JonCra/Smokehouse/ControlStation/Schematics/Board 1 - Control Station_MASTER/ControlStationPCB_Front.png

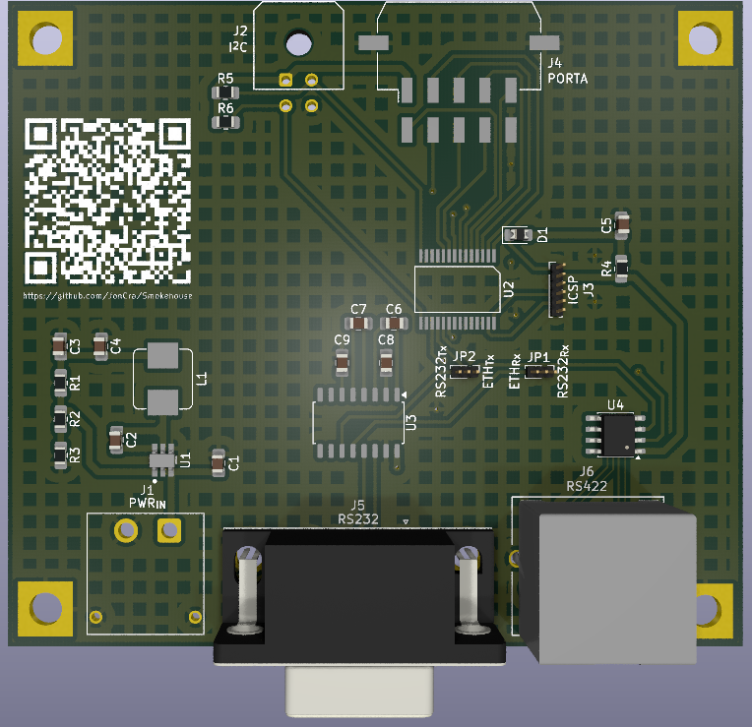
ControlStation/Schematics/Board 1 - Control Station_MASTER/ControlStationPCB_Front.png
