JonCra/Smokehouse/ControlStation/Images-Assets/FunctionalTestCircuit.png

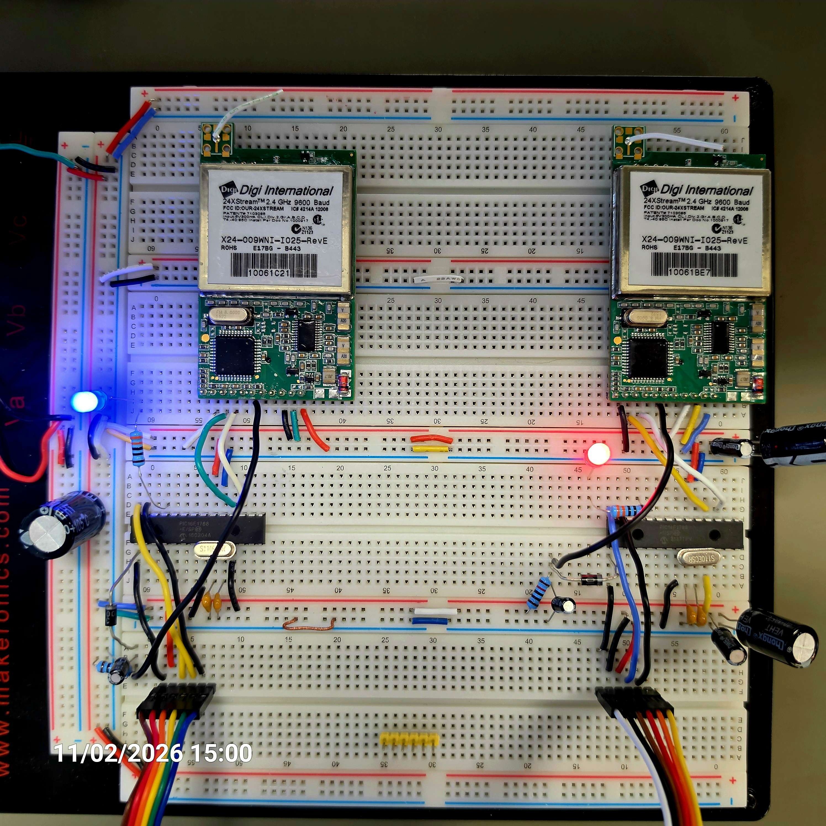
ControlStation/Images-Assets/FunctionalTestCircuit.png
