JonCra/Smokehouse/README.md

# Project Smokehouse - RCET Project (Fall 2026 Semester)
## Continuation of [Project BLOODHOUND](https://github.com/rc-earnest/BloodHound)
### Smokehouse Contributors (Fall 2026 Semester)
<dl>
<dt>Micah Spencer - Project Lead, 6th Semester RCET Student</dt>
<dd>Redesign and improvement of drive controller(s) and addition of semi-permanent peripheral data collection</dd>
<dt>Jonas Cram - Project Lead, 6th Semester RCET Student</dt>
<dd>Design and construction of "control/base station" for remote operations</dd>
</dl>

### BLOODHOUND Contributors (Spring 2026 Semester)
<dl>
<dt>Noah Holloway - Project Lead, 6th Semester RCET Student</dt>
<dd>ATV steering/driving controls and physical/electrical hardware</dd>
<dt>Rudy Earnest - Project Lead, 6th Semester RCET Student</dt>
<dd>Pan-Tilt-Zoom (PTZ) Cameras and other peripherals</dd>
<dt>Micah Spencer - Project Assistant, 5th Semester RCET Student</dt>
<dd>Real-Time Kinematics (RTK)/GPS Module</dd>
<dt>Jonas Cram - Project Assistant, 5th Semester RCET Student</dt>
<dd>Light Detection and Ranging (LiDAR) Module</dd>
