JonCra/Smokehouse/ControlStation/Images-Assets/OriginalControlStation_Uncovered.jpg

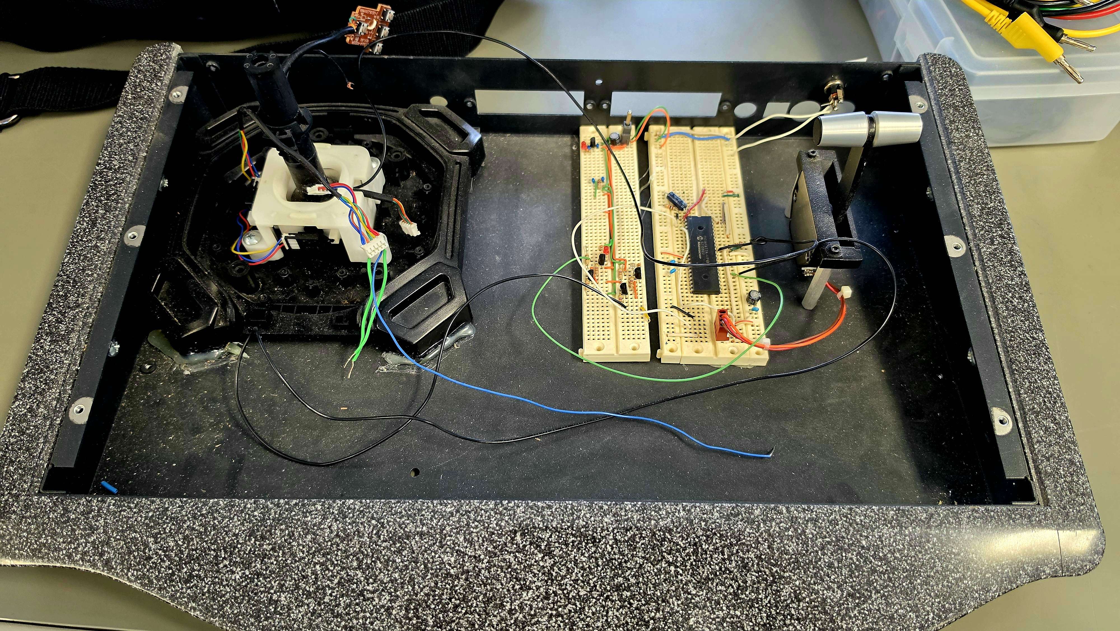
ControlStation/Images-Assets/OriginalControlStation_Uncovered.jpg
