JonCra/Smokehouse/ControlStation/Images-Assets/ReceiverBoard_Back.png

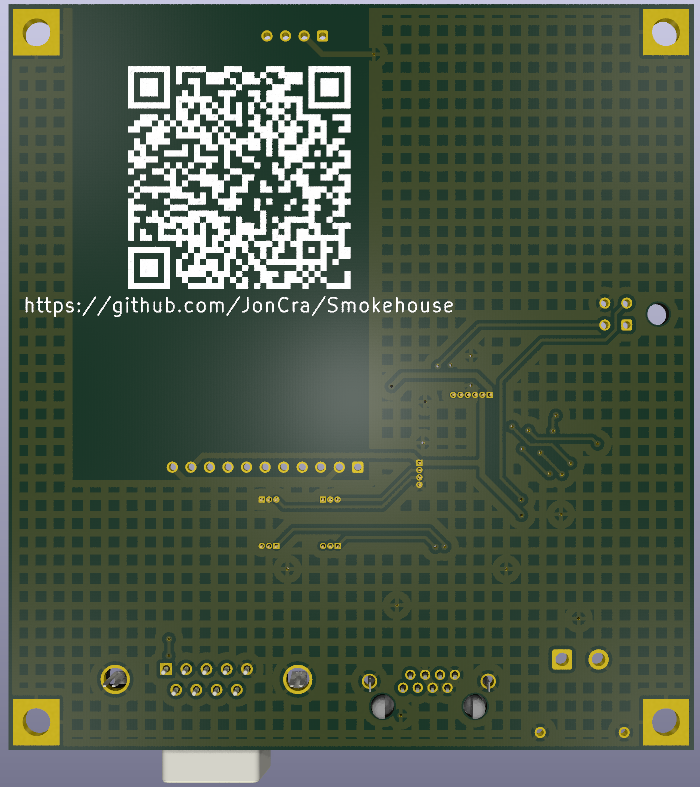
ControlStation/Images-Assets/ReceiverBoard_Back.png
