JonCra/Smokehouse/ControlStation/Images-Assets/ReceiverBoard_Front.png

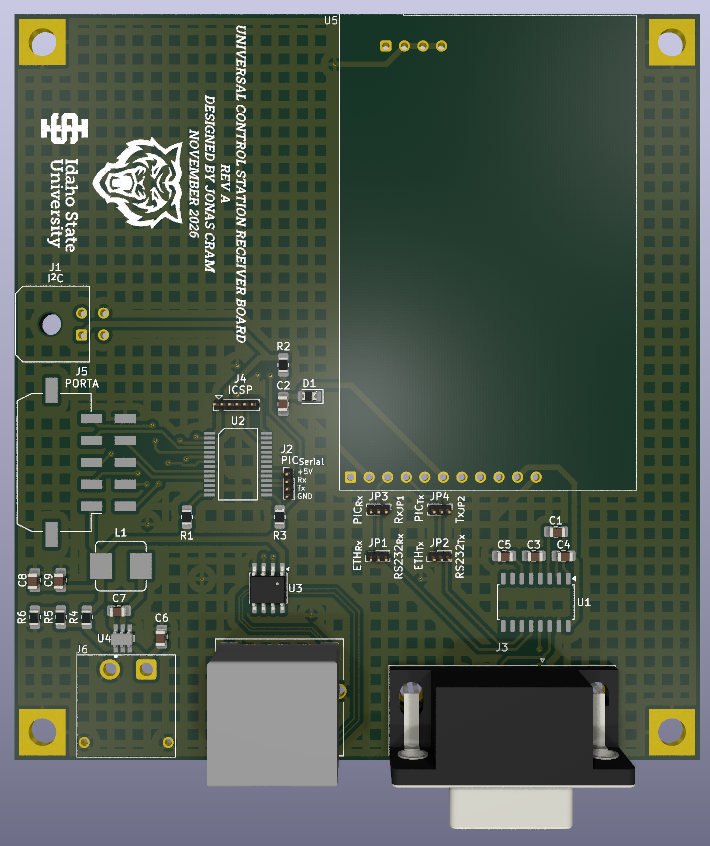
ControlStation/Images-Assets/ReceiverBoard_Front.png
