JonCra/Smokehouse/ControlStation/Images-Assets/RX_PIC_LED_Period.png

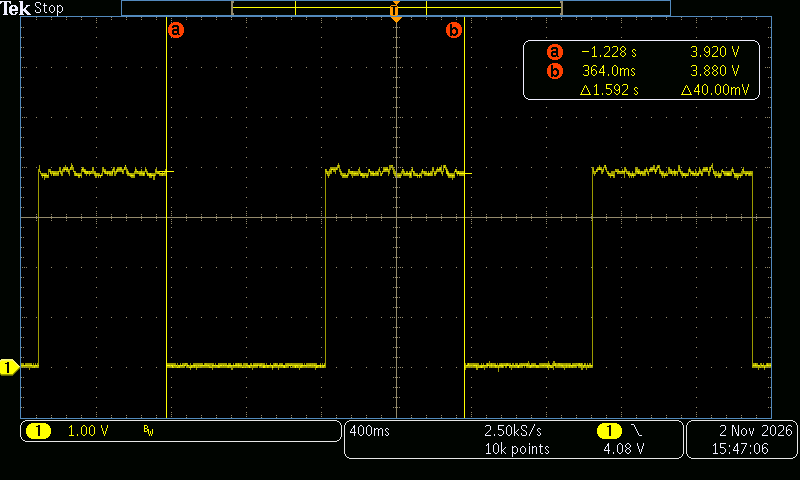
ControlStation/Images-Assets/RX_PIC_LED_Period.png
