JonCra/Smokehouse/ControlStation/Images-Assets/TX_PIC_LED_Period.png

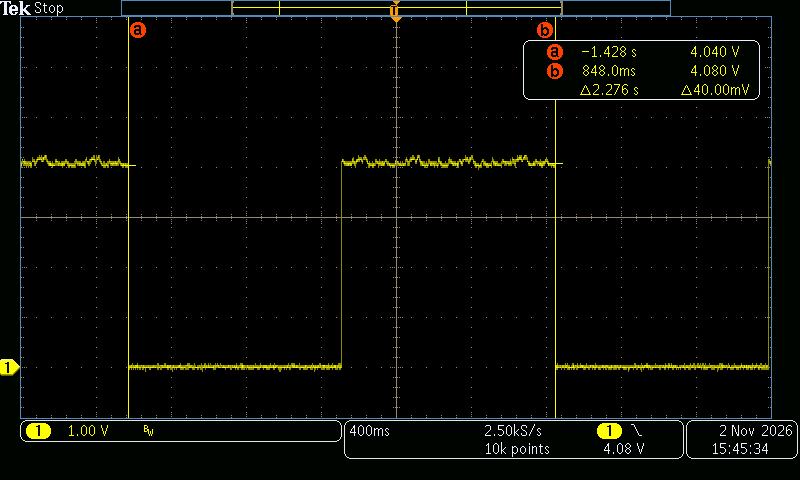
ControlStation/Images-Assets/TX_PIC_LED_Period.png
