JonCra/Smokehouse/ControlStation/Schematics/Board 1 - Control Station_MASTER/ControlStationPCB_Back.png

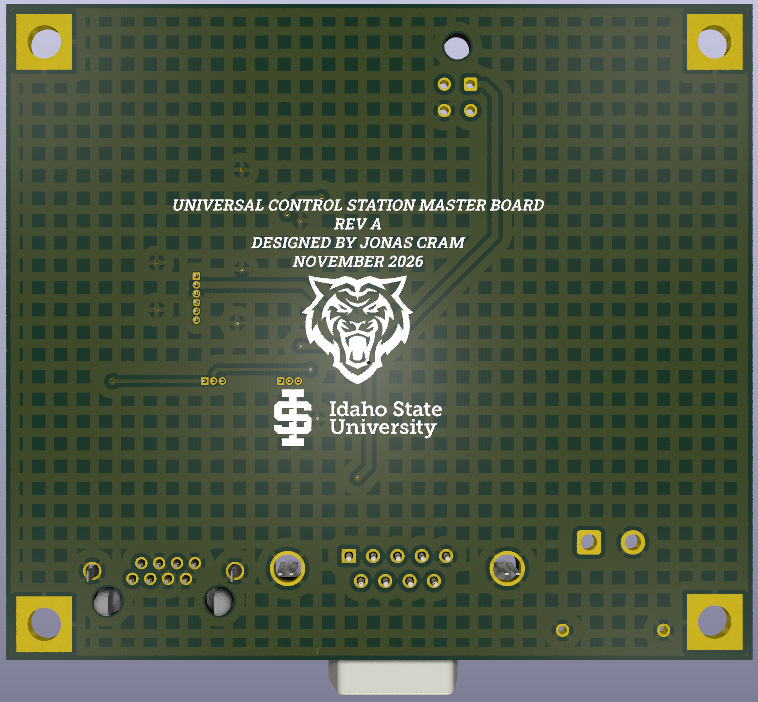
ControlStation/Schematics/Board 1 - Control Station_MASTER/ControlStationPCB_Back.png
