JonCra/Smokehouse/ControlStation/Schematics/Board 2 - Receiver_SLAVE/ReceiverBoard_BOM.pdf

# | Reference | Qty | Value | Description | Footprint | Digikey Part | Unit Price | Price / 100 units | Total Price

1 | C1, C3, C4, C5 | 4 | 1μF | CAP0805 Y5V 1UF Z-TOL 50V | Capacitor_SMD:C_0805_2012Metric_Pad1.1 8x1.45mm_HandSolder | 4713-GMC21Y5V105Z5 0NTTR-ND | $ 0.13 | $ 0.04 | $ 0.52
2 | C2 | 1 | 10μF | CAP0805 X5R 10UF 20% 50V | | 4713-GMC21X5R106M 50NTTR-ND | $ 1.62 | $ 0.79 | $ 1.62
3 | C6 | 1 | 2.2μF | CAP0805 X7R 2.2UF 10% 50V | | 4713-GMC21X7R225K 50NTTR-ND | $ 0.36 | $ 0.14 | $ 0.36
4 | C7 | 1 | 100nF | CAP0805 X7R .1UF 10% 50V | | 4713-GMC21X7R104K5 0NTTR-ND | $ 0.10 | $ 0.03 | $ 0.10
5 | C8, C9 | 2 | 22μF | CAP0805 X5R 22UF 20% 25V | | 4713-GMC21X5R226M 25NTTR-ND | $ 0.76 | $ 0.33 | $ 1.52
6 | D1 | 1 | 1N4148 or Equivelant | DIODE STANDARD 75V 150MA 0805 | | 1801-TS4148RBGTR-ND | $ 0.13 | $ 0.05 | $ 0.13
7 | J1 | 1 | I 2C | CONN HEADER R/A 4POS 3MM | Connector_Molex:Molex_Micro-Fit_3.0_43045-0400_2x02_P3.00mm_Horizontal | WM1814-ND | $ 1.45 | $ 1.05 | $ 1.45
8 | J2 | 1 | PICSerial | NA | Connector_PinHeader_1.00mm:PinHeader_ 1x04_P1.00mm_Vertical | NA | IN-LAB STOCK
9 | J3 | 1 | RS232 | CONN D-SUB RCPT 9POS R/A SOLDER | Connector_Dsub:DSUB-9_Socket_Horizontal_P2.77x2.84mm_Edge PinOffset7.70mm_Housed_MountingHoles Offset9.12mm | AE10921-ND | $ 0.85 | | $ 0.85
10 | J4 | 1 | ICSP | NA | Connector_PinHeader_1.00mm:PinHeader_ 1x06_P1.00mm_Vertical | NA | IN-LAB STOCK
11 | J5 | 1 | PORTA | CONN HEADER SMD R/A 10POS 3MM | Connector_Molex:Molex_Micro-Fit_3.0_43045-1010_2x05-1MP_P3.00mm_Horizontal | 23-0430451011CT-ND | $ 5.89 | $ 4.25 | $ 5.89
12 | J6 | 1 | PWRIN | Connector: DC supply; socket; XT30; female; power supply; 15A; 500V | cramjona_customLib:XT30PW-M | https://www.tme.com | $ 1.50 | $ 0.73 | $ 1.50
/us/enus/details/xt30pwf/dc-powerconnectors/amass/?u
tm_source=chatgpt.c
om
13 | J7 | 1 | RJ45Shielded | CONN MOD JACK 8P8C R/A SHLD | cramjona_customLib:CONN8_406541_TEC | RJHSE5E80-ND | $ 1.83 | $ 1.32 | $ 1.83
14 | JP1 | 1 | Rxselect1 | NA | Connector_PinHeader_1.00mm:PinHeader_ 1x03_P1.00mm_Vertical | NA | IN-LAB STOCK
15 | JP2 | 1 | Txselect1
16 | JP3 | 1 | Rxselect2
17 | JP4 | 1 | Txselect2
18 | L1 | 1 | 33μH | 33 µH Shielded Molded Inductor 2.4 A 220mOhm Max 2-SMD | Inductor_SMD:L_Bourns_SRP7028A_7.3x6. 6mm | 4044-CSAB0740-330MTR-ND | $ 0.35 | $ 0.24 | $ 0.35
19 | R1, R3 | 2 | 470Ω | RES 470 OHM 1% 1/8W 0805 | Resistor_SMD:R_0805_2012Metric_Pad1.20 x1.40mm_HandSolder | CRGCQ0805F470 R | $ 0.10 | $ 0.02 | $ 0.20
20 | R2 | 1 | 10kΩ | RES SMD 10K OHM 0.5% 1/10W 0805 | | RR1220P-103-D | $ 0.10 | $ 0.03 | $ 0.10
21 | R4 | 1 | 47kΩ | RES 47K OHM 1% 1/8W 0805 | | CRGCQ0805F47K | $ 0.10 | $ 0.02 | $ 0.10
22 | R5 | 1 | 5.6kΩ | RES SMD 5.6K OHM 5% 1/8W 0805 | | ERJ-6GEYJ562V | $ 0.10 | $ 0.02 | $ 0.10
23 | R6 | 1 | 3.3kΩ | RES 3.3K OHM 5% 1/8W 0805 | | A130137TR-ND | $ 0.10 | $ 0.02 | $ 0.10
24 | U1 | 1 | MAX232 | Dual RS232 driver/receiver, 5V supply, 120kb/s, 0C-70C | Package_SO:SOP-16_4.55x10.3mm_P1.27mm | 296-36944-2-ND | $ 1.28 | $ 0.74 | $ 1.28
25 | U2 | 1 | PIC16F1788 | IC MCU 8BIT 28KB FLASH 28SOIC | cramjona_customLib:SSOP-28 | PIC16F1788-I/SO | $ 2.63 | $ 2.17 | $ 2.63
26 | U3 | 1 | ST490AB | 1/1 Transceiver Full RS422, RS485 8-SOIC | Package_SO:SO-8_3.9x4.9mm_P1.27mm | 497-2091-2-ND | $ 2.64 | $ 1.61 | $ 2.64
27 | U4 | 1 | LMR51635 | SIMPLE SWITCHER SYNCHRONOUS BUCK | CramJona_FootprintLib:DDC0006A-MFG | 296-LMR51635XFDD CRTR-ND | $ 2.53 | $ 1.54 | $ 2.53
28 | U5 | 1 | 24XStream | 2.4GHz OEM RF Module | cramjona_customLib:24XStream | OBSOLETE X24-009WNI-ND | $ 55.66 | $50.93 (Obsolete, est. value) | $ 55.66
| | | | | | | TOTAL PRICE: | | $ 81.46
