JonCra/Smokehouse/ControlStation/Schematics/UART_TestCircuit.pdf

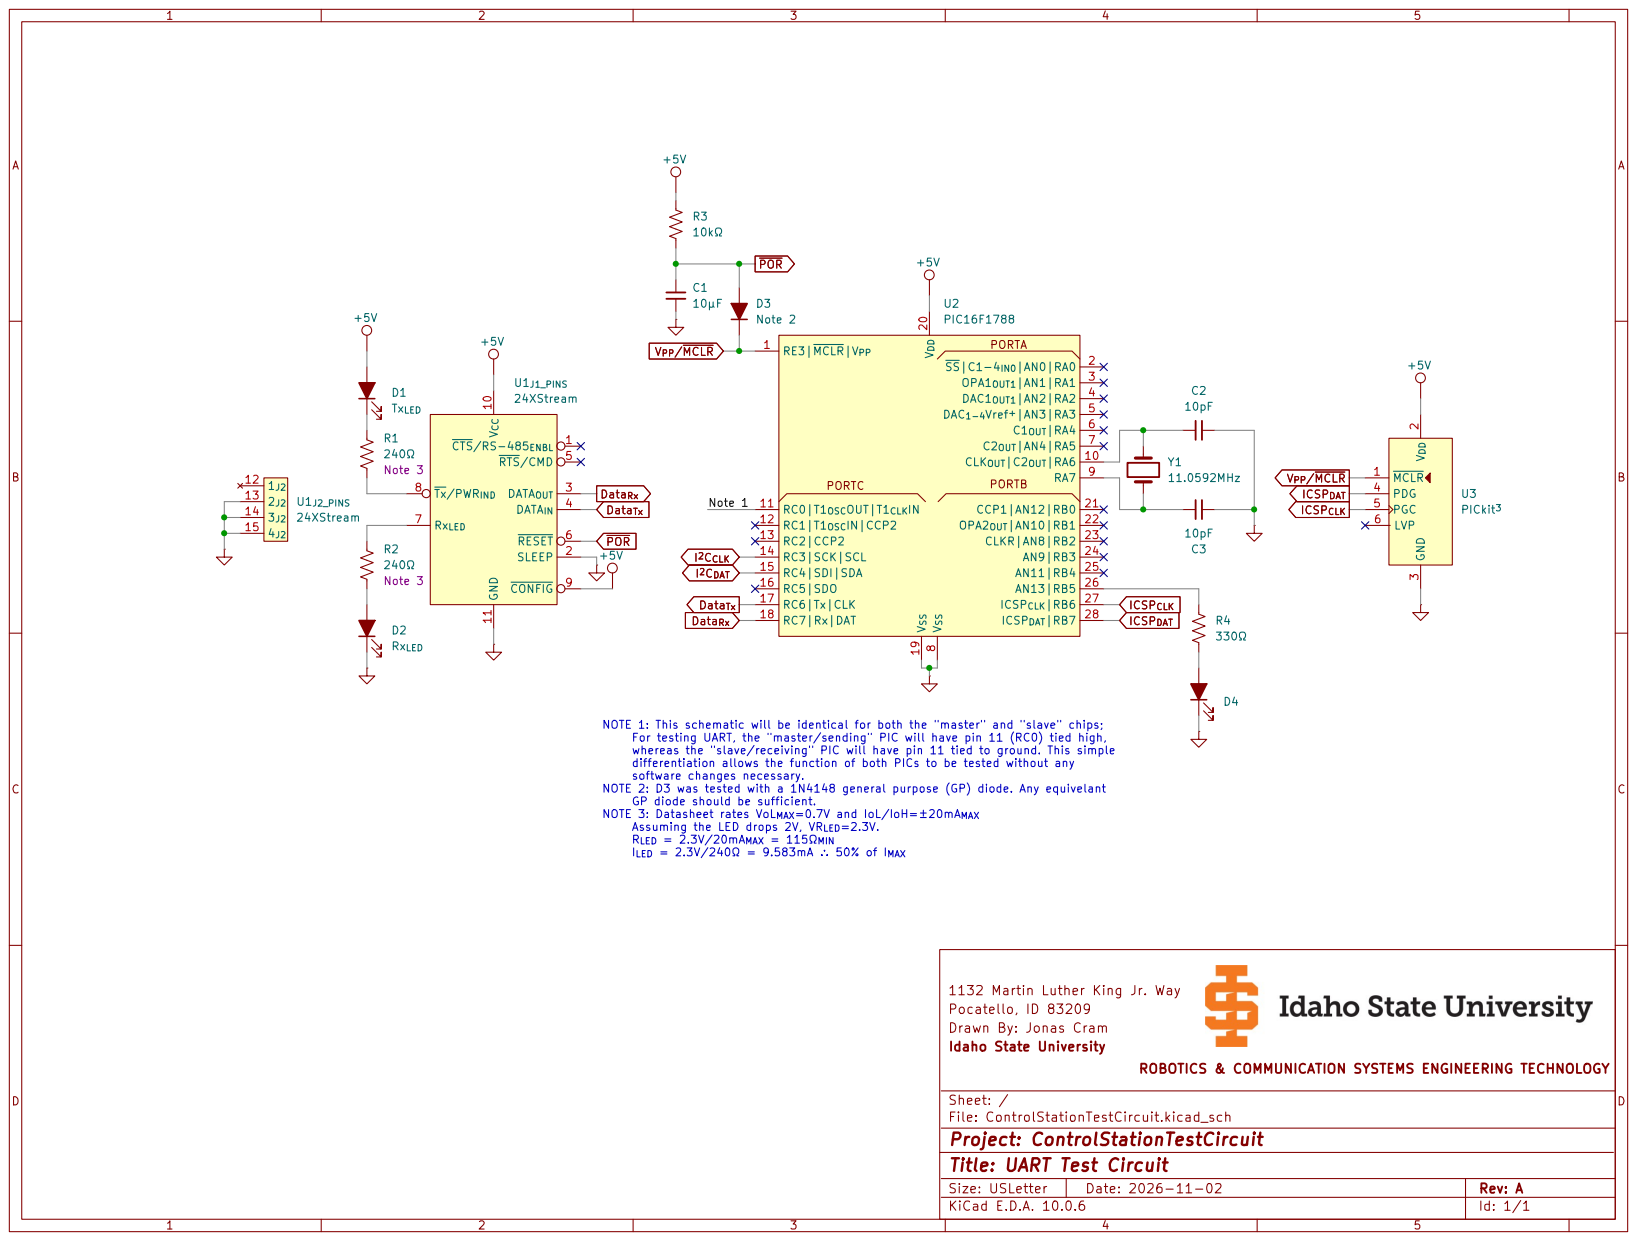
[picture p9: page 1]
