JonCra/Smokehouse/ControlStation/Schematics/UART_TestCircuit_BW.pdf

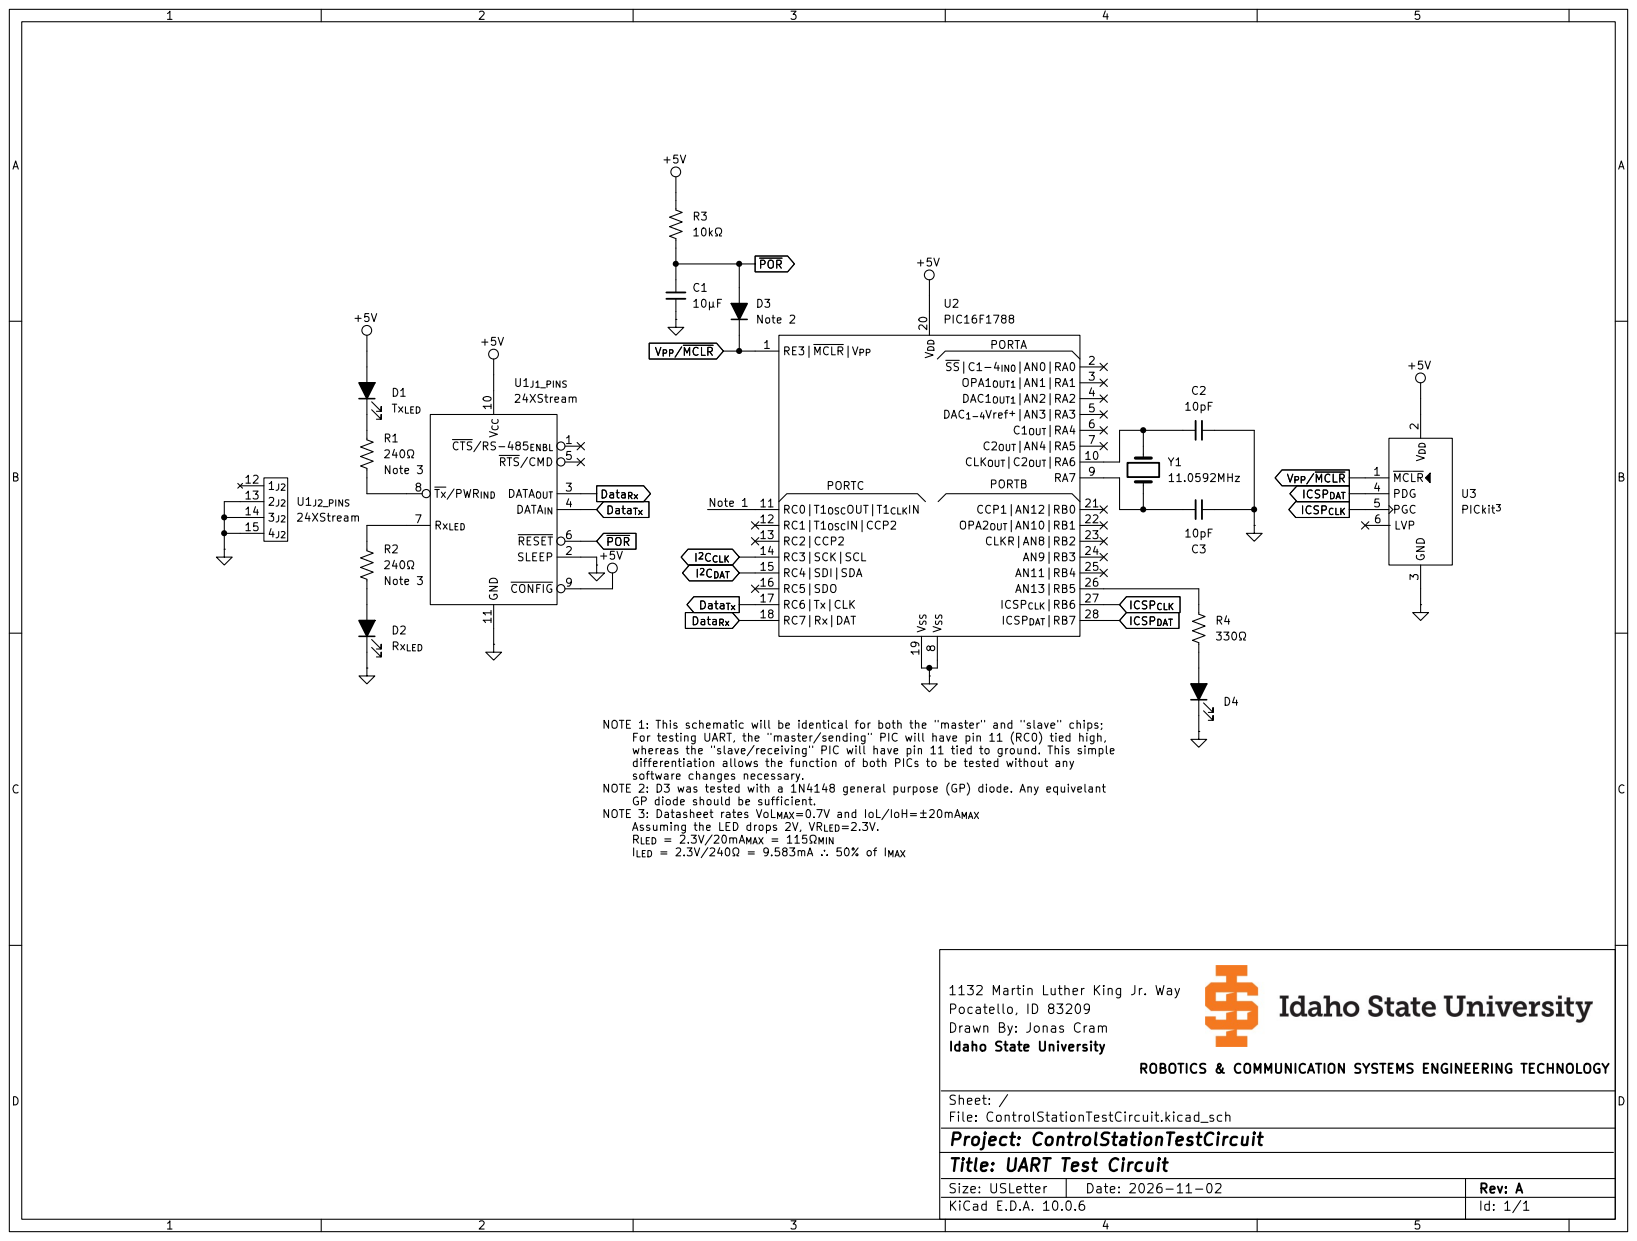
[picture p10: page 1]
