JonCra/Smokehouse/ControlStation/Schematics/Board 2 - Receiver_SLAVE/ReceiverSchematic.pdf

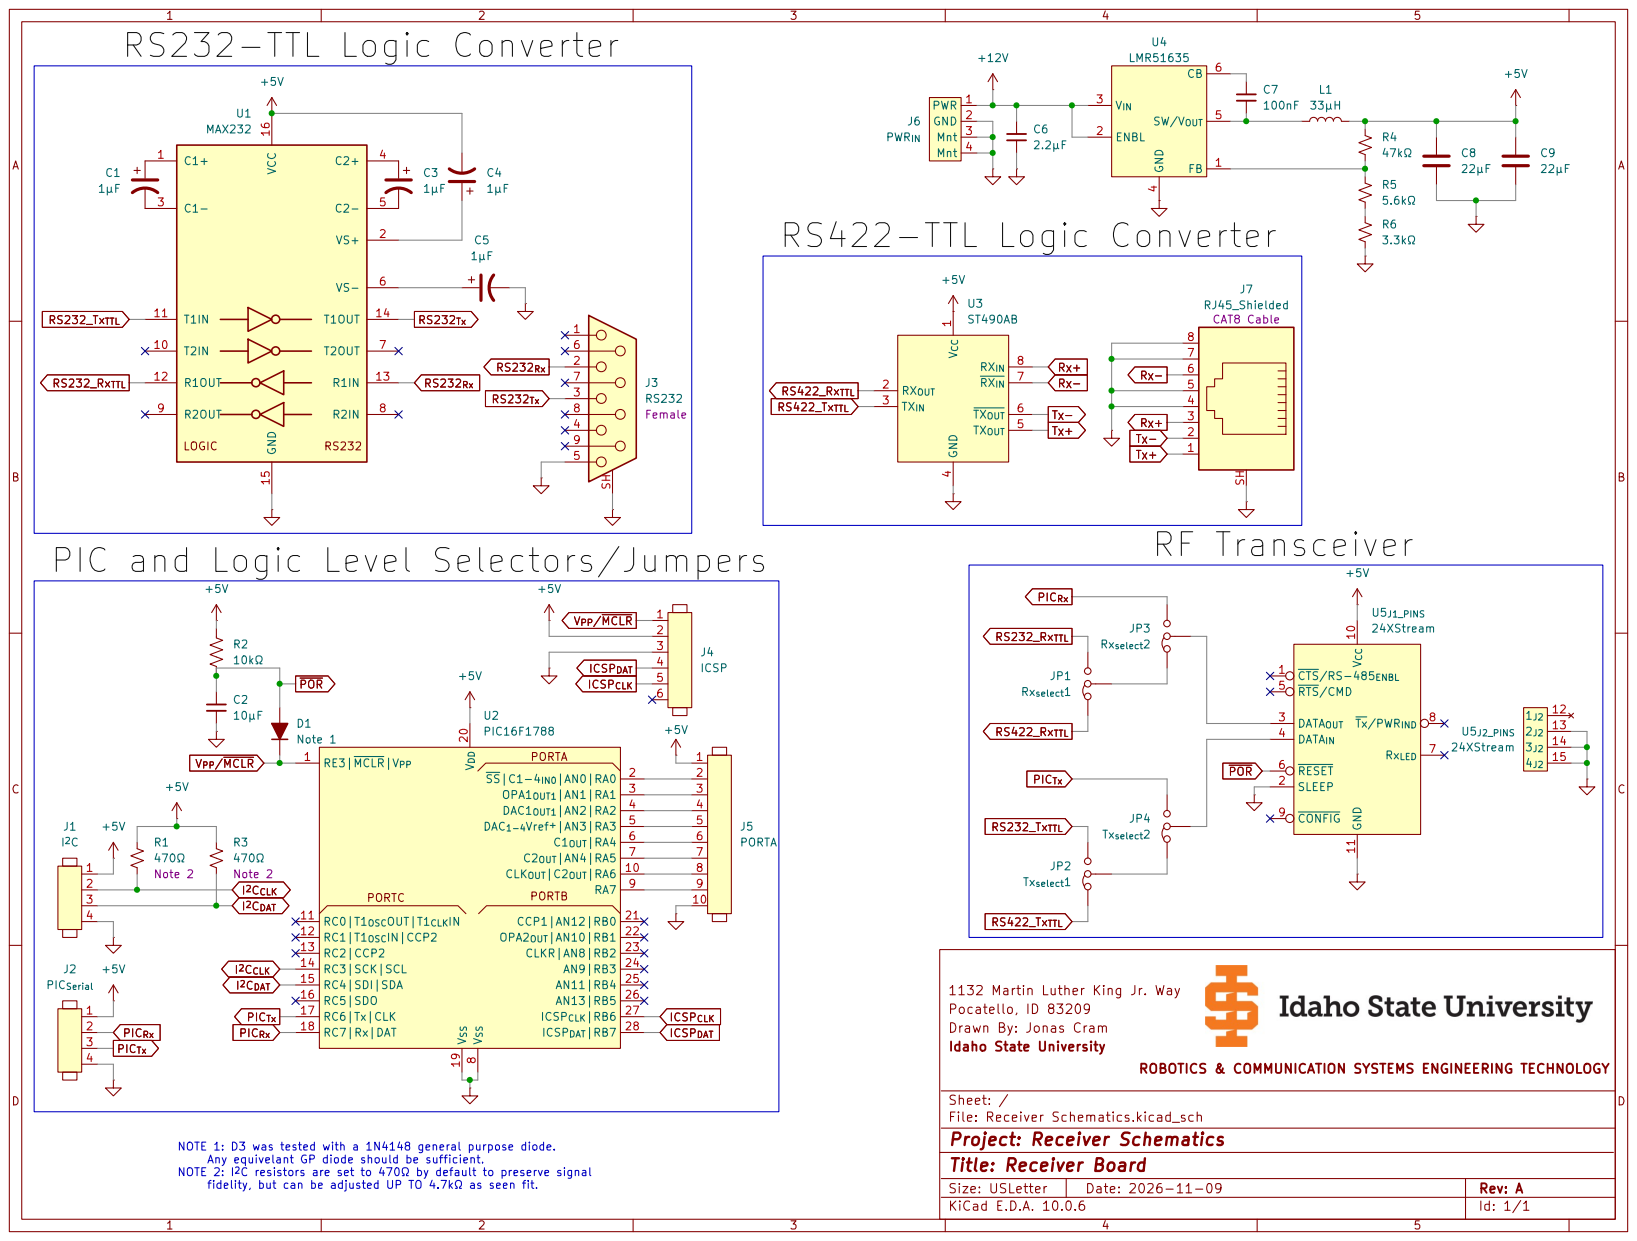
[picture p11: page 1]
