JonCra/Smokehouse/ControlStation/Schematics/Board 2 - Receiver_SLAVE/ReceiverSchematicBW.pdf

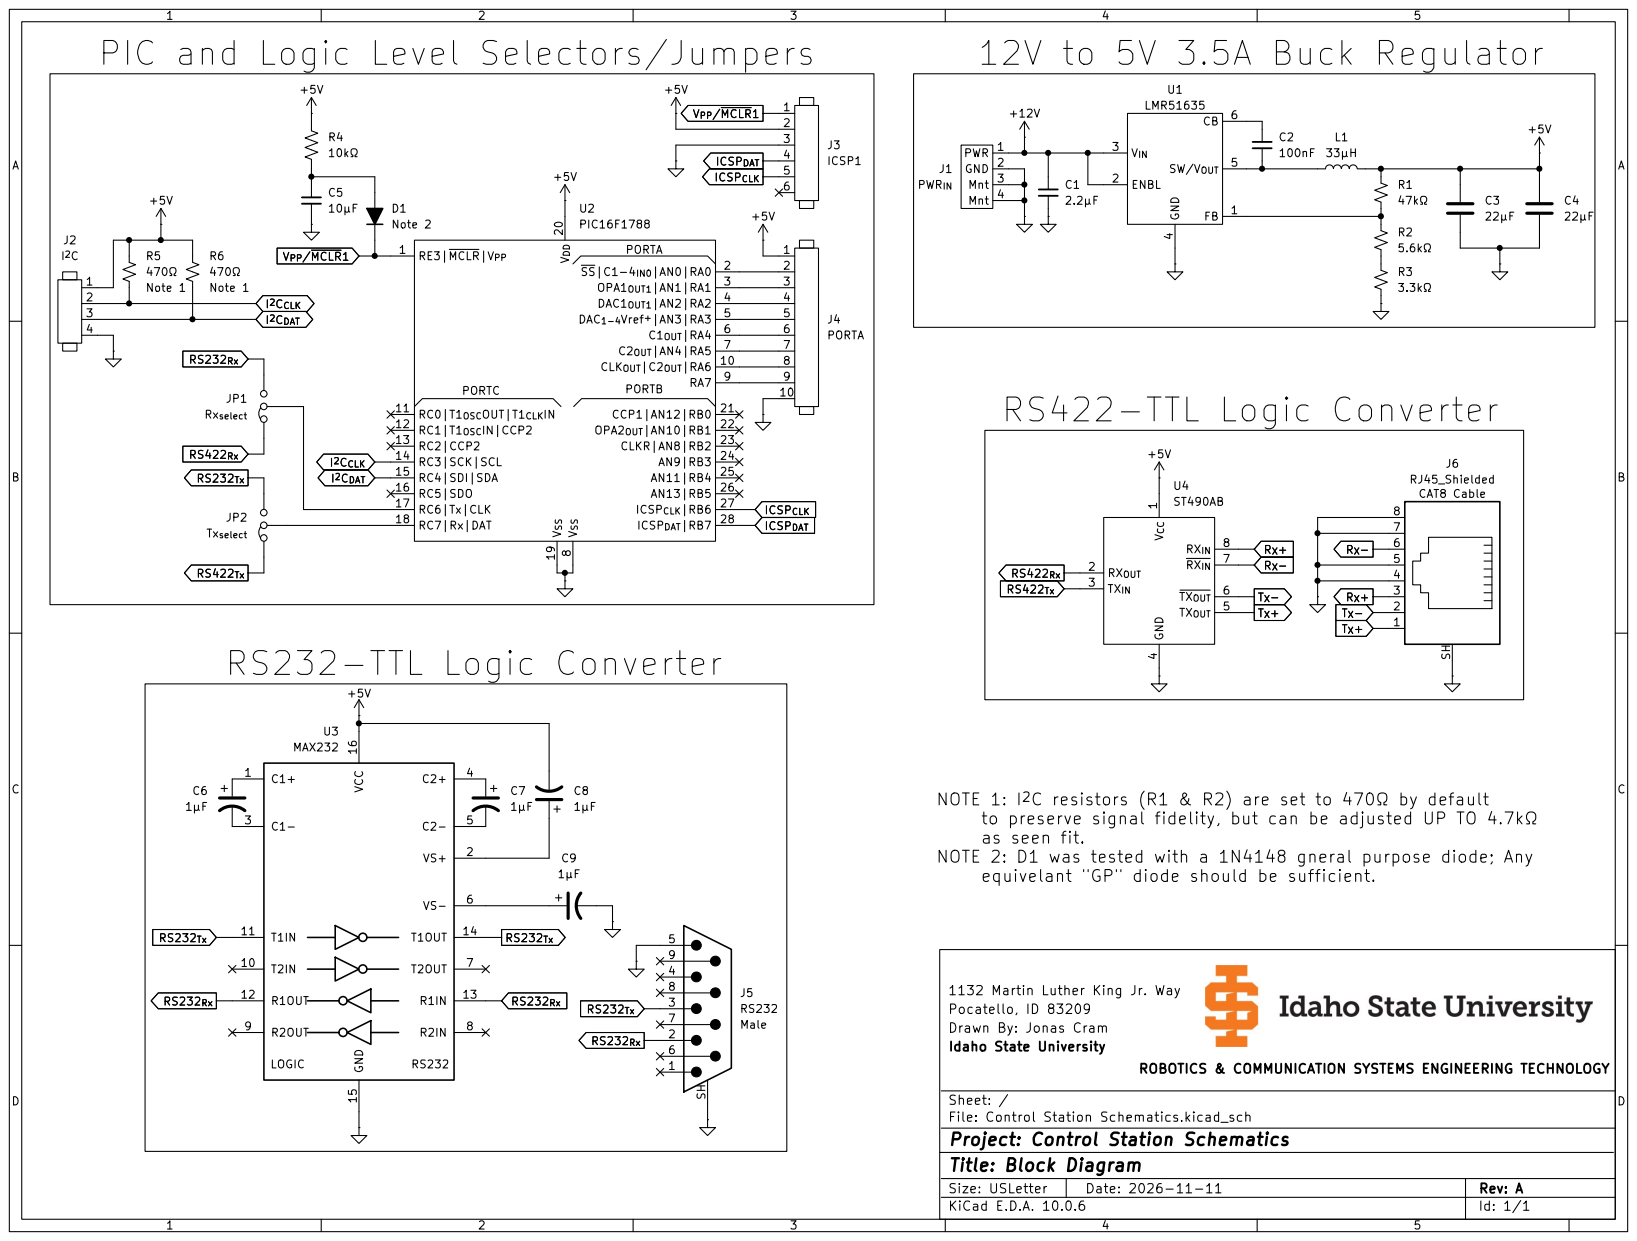
[picture p12: page 1]
