JonCra/Smokehouse/ControlStation/Schematics/Board 2 - Receiver_SLAVE/ReceiverPCB_Layered.pdf

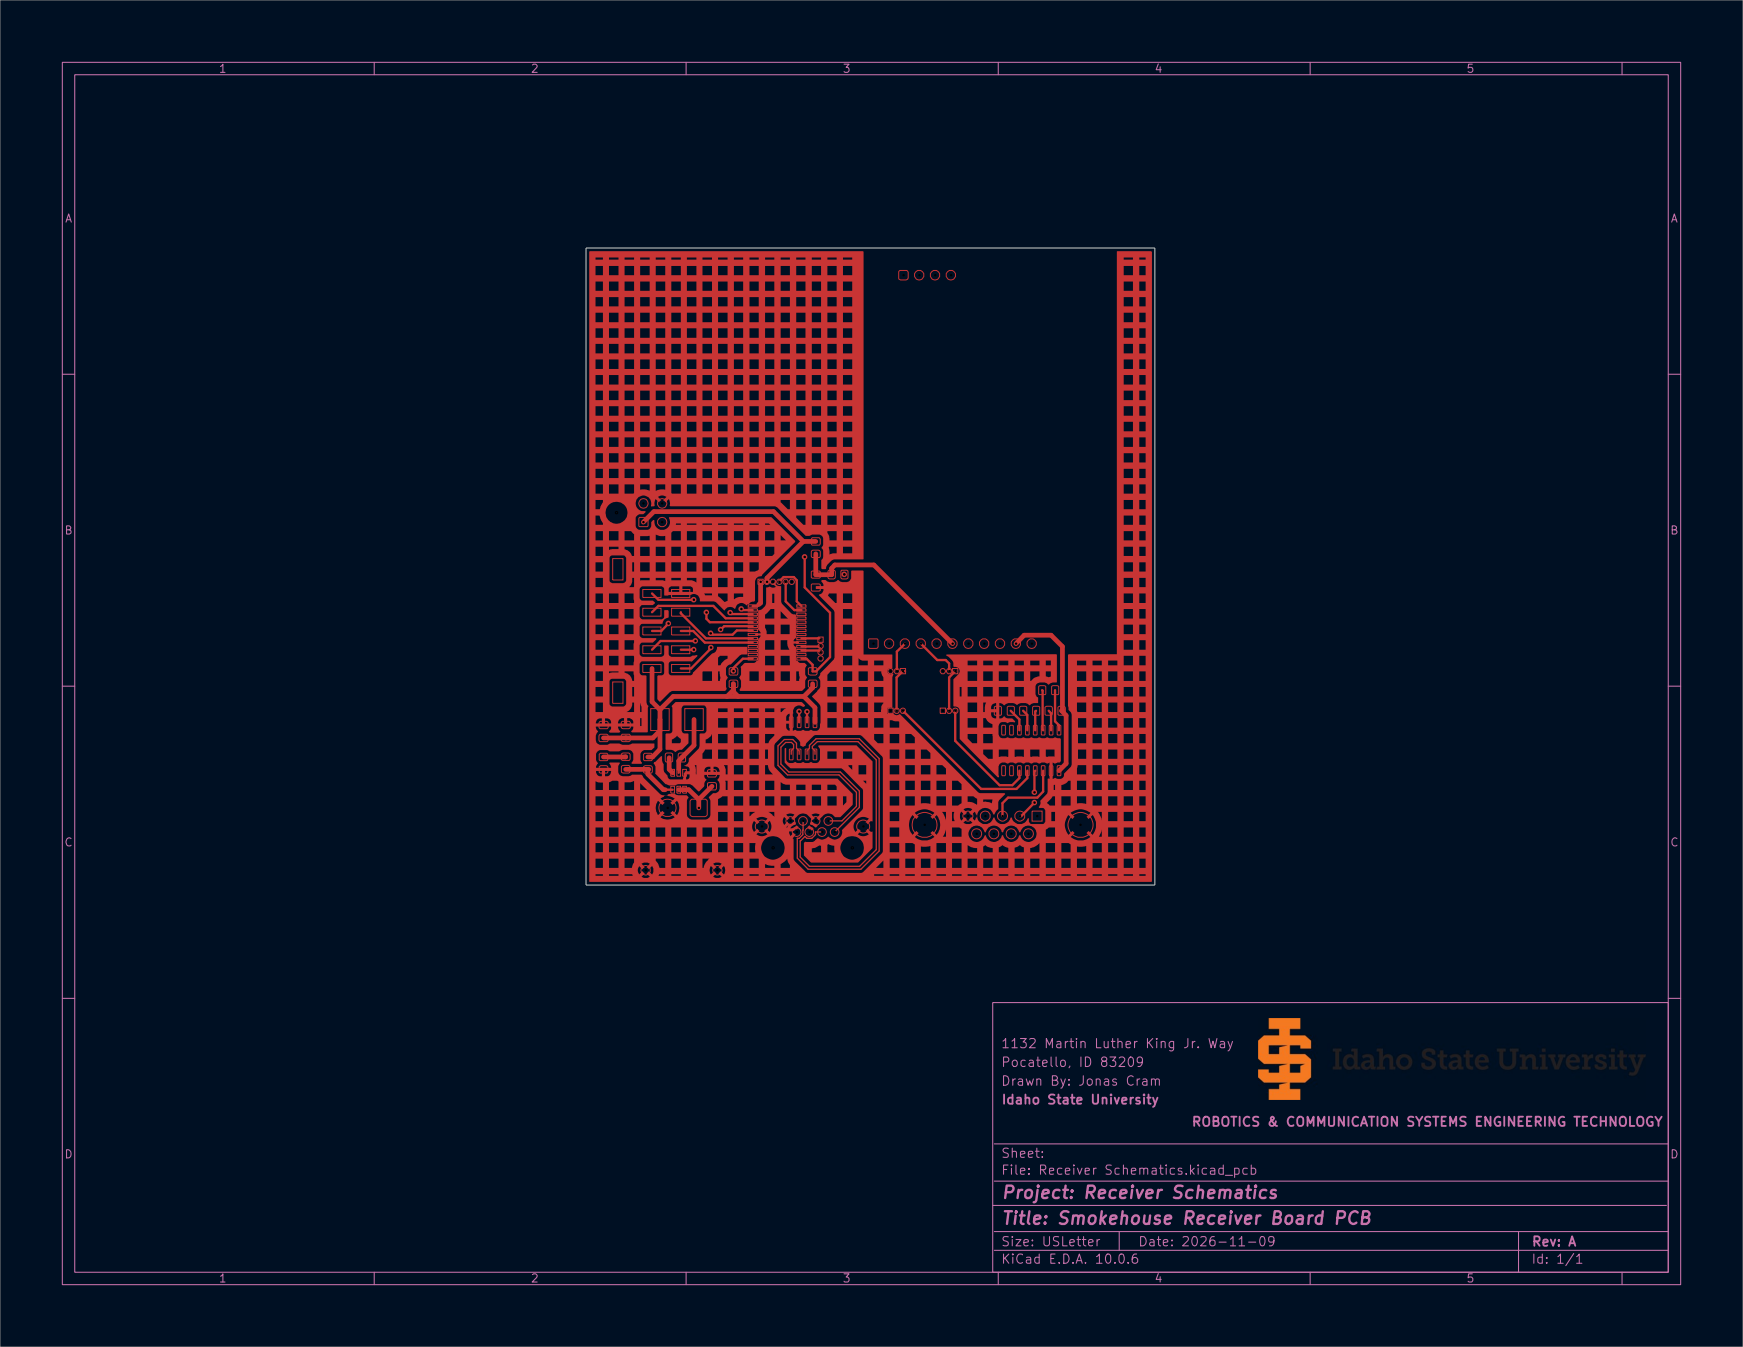
[picture p33: page 1]

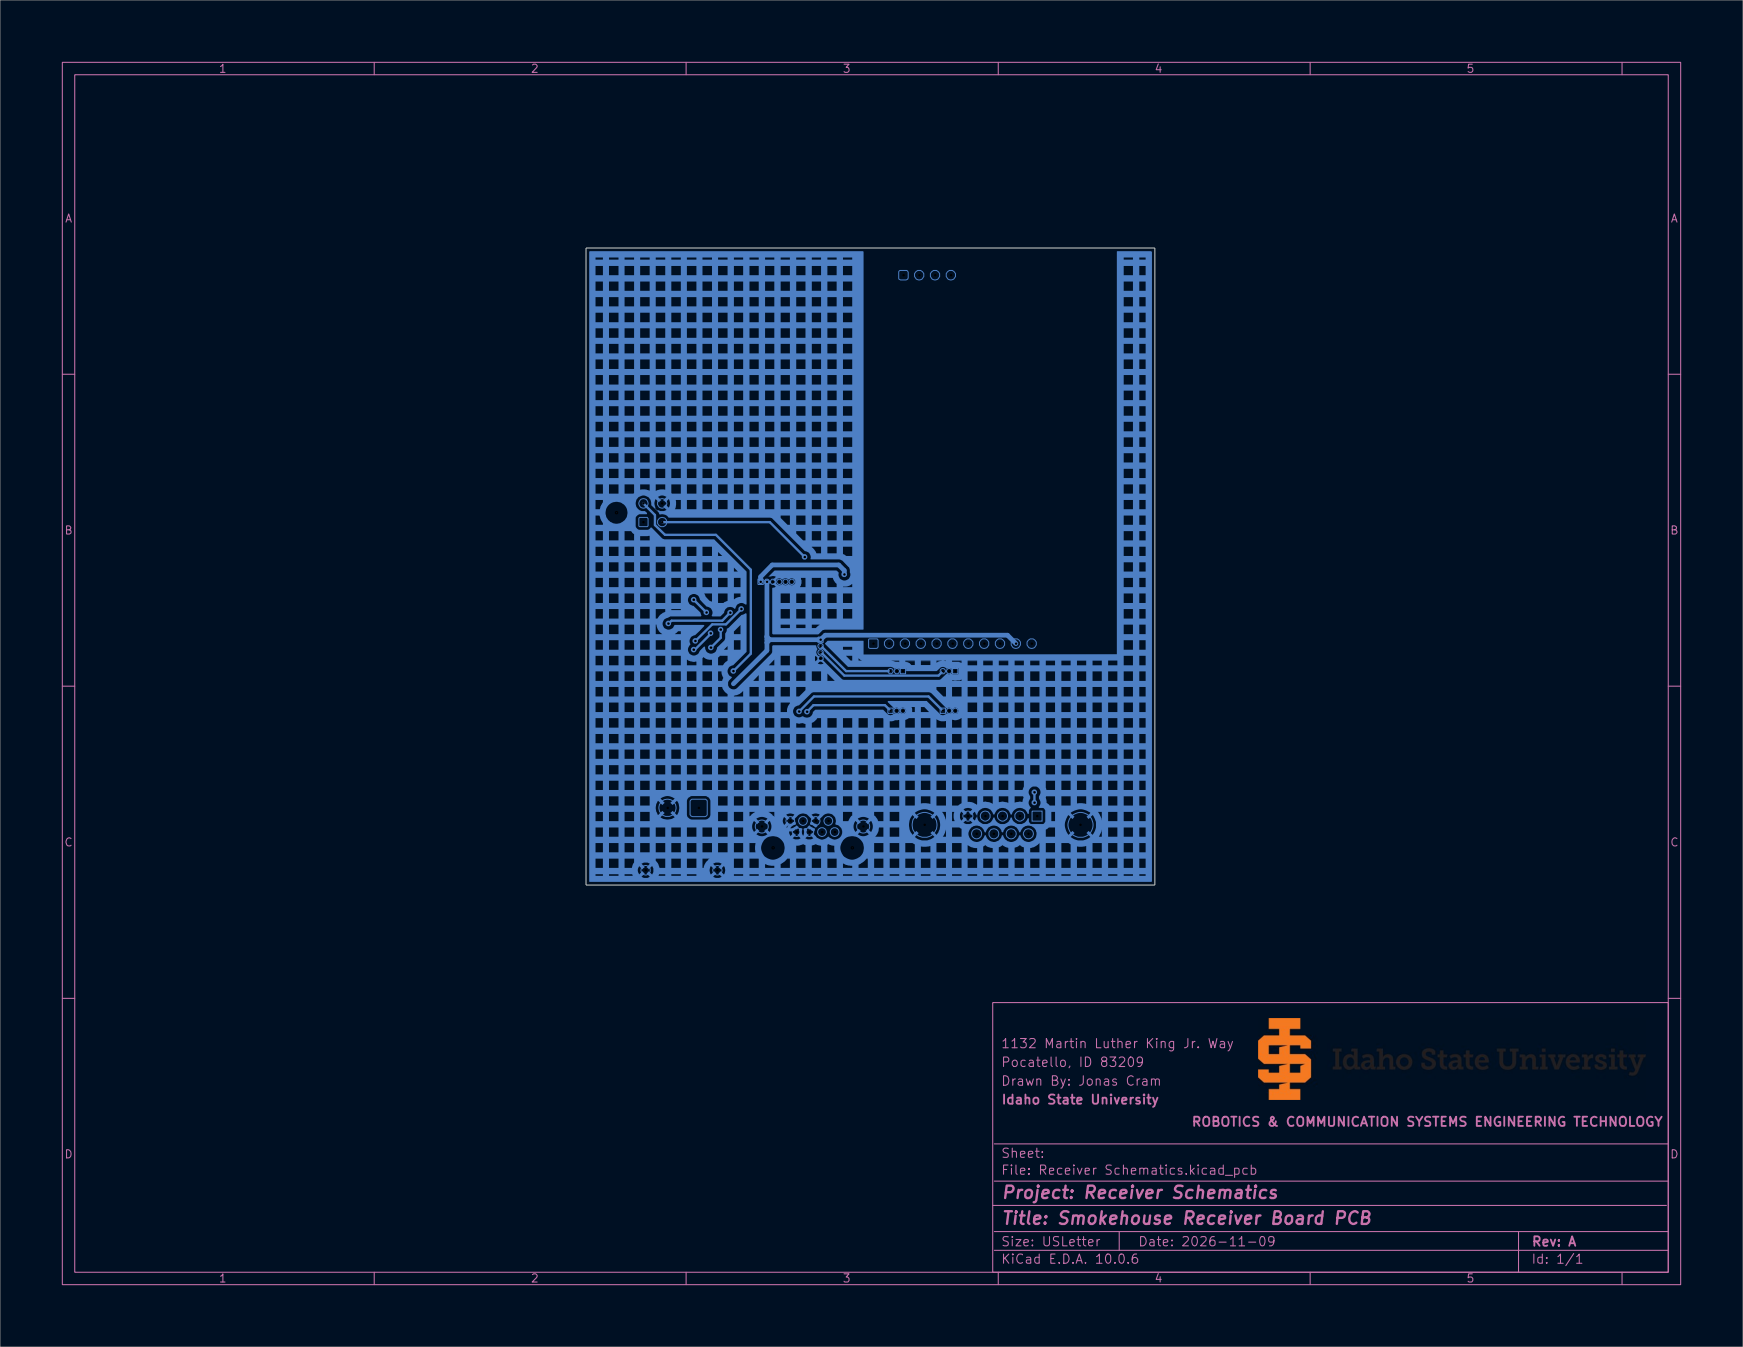
[picture p34: page 2]

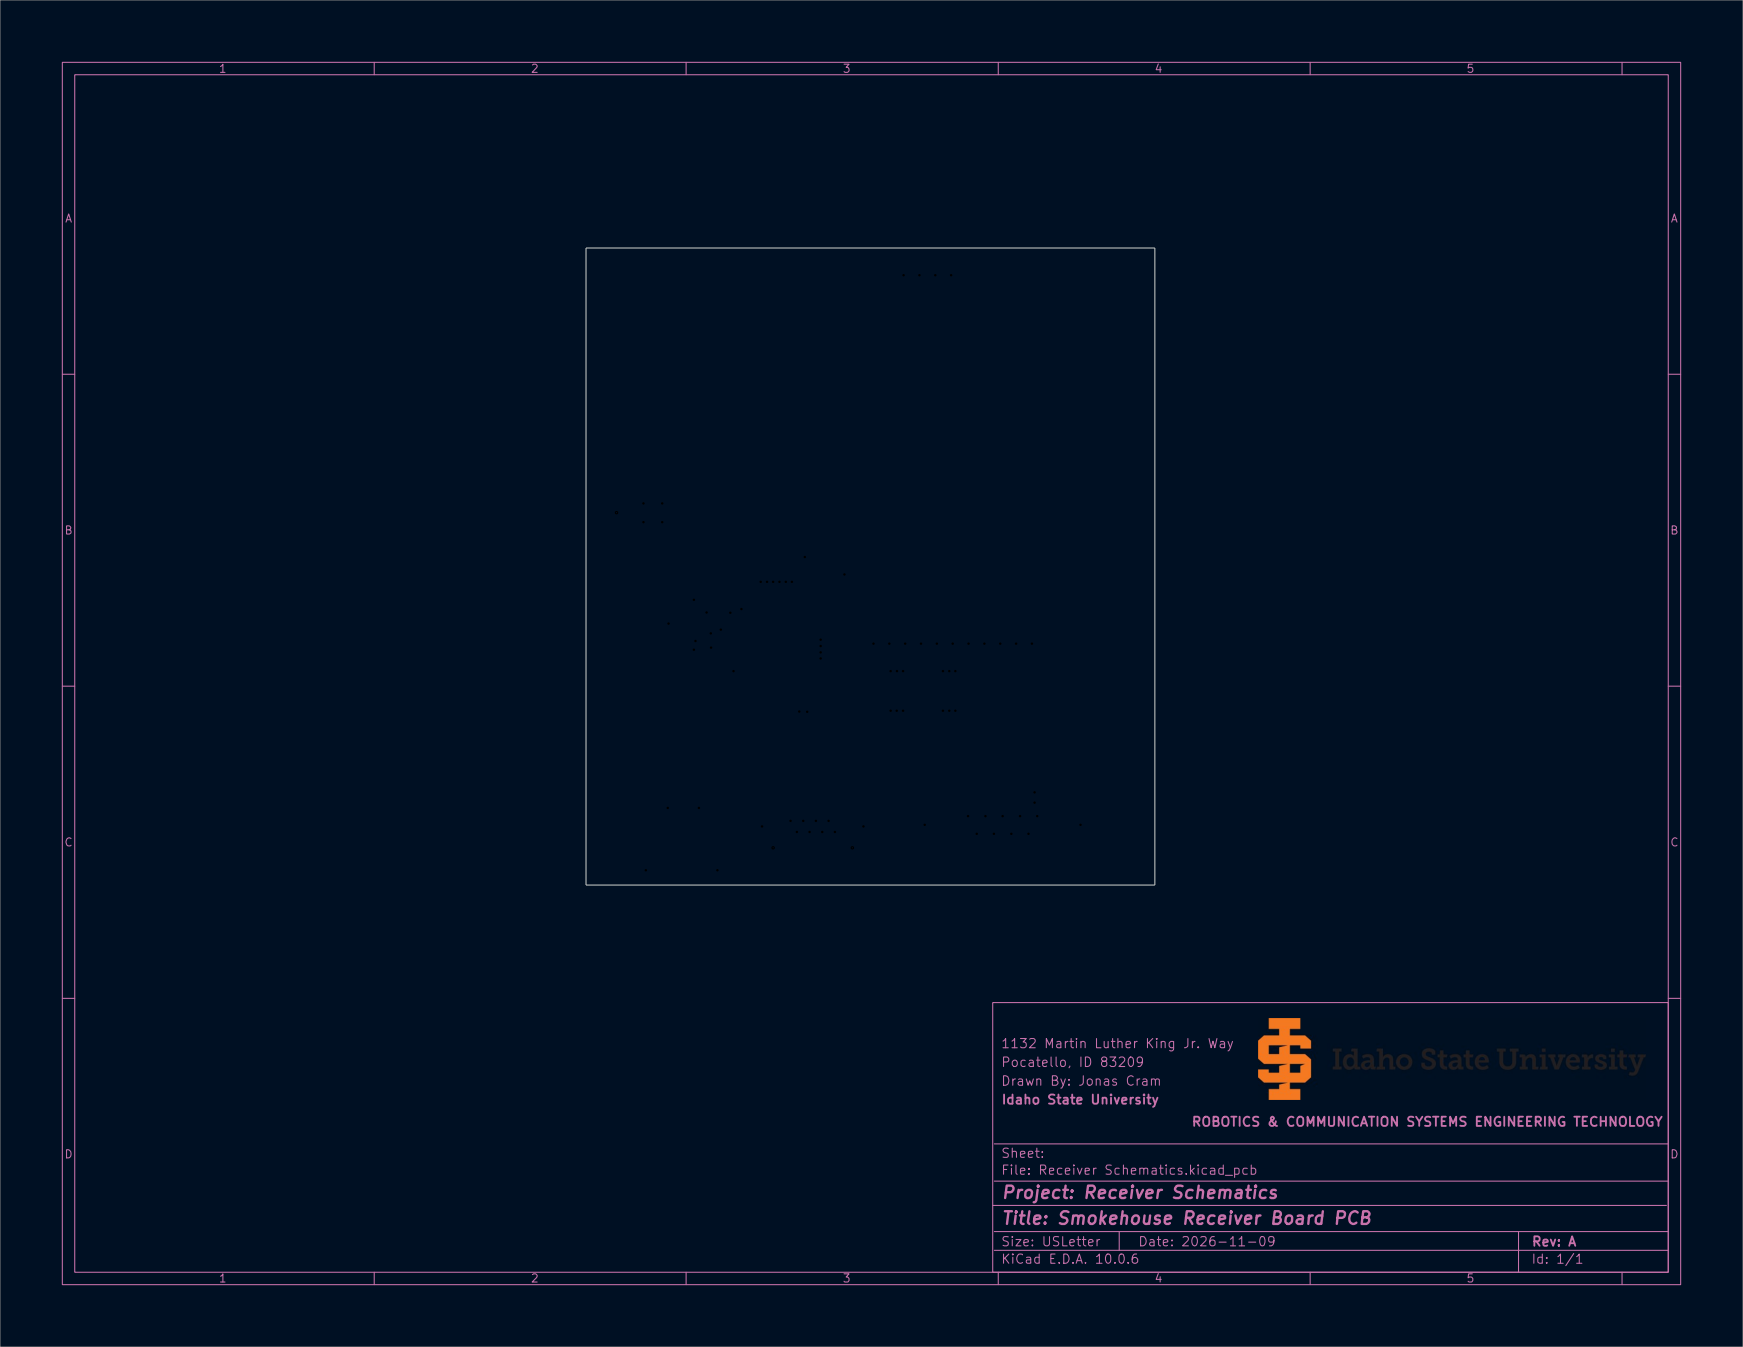
[picture p35: page 3]

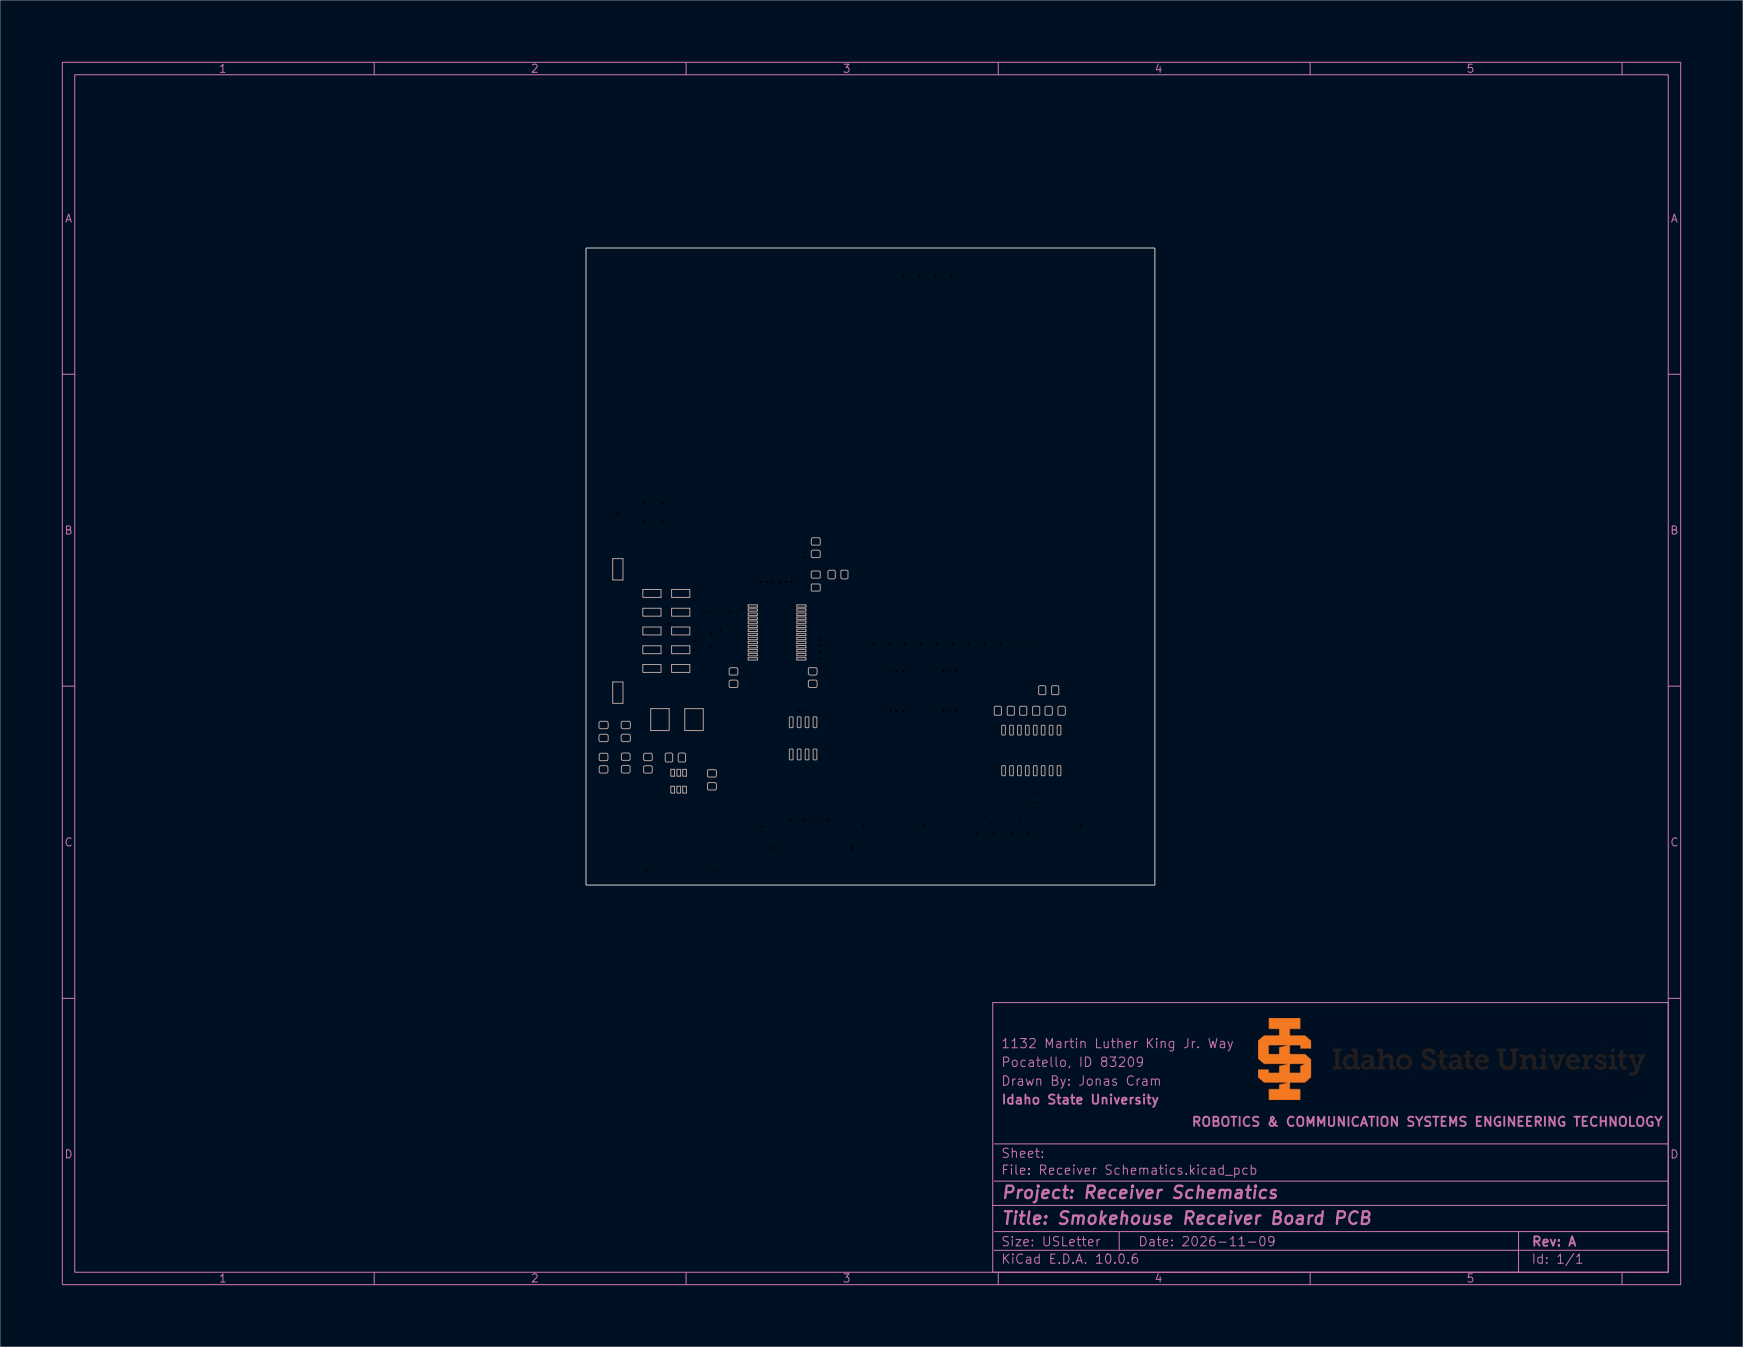
[picture p36: page 5]

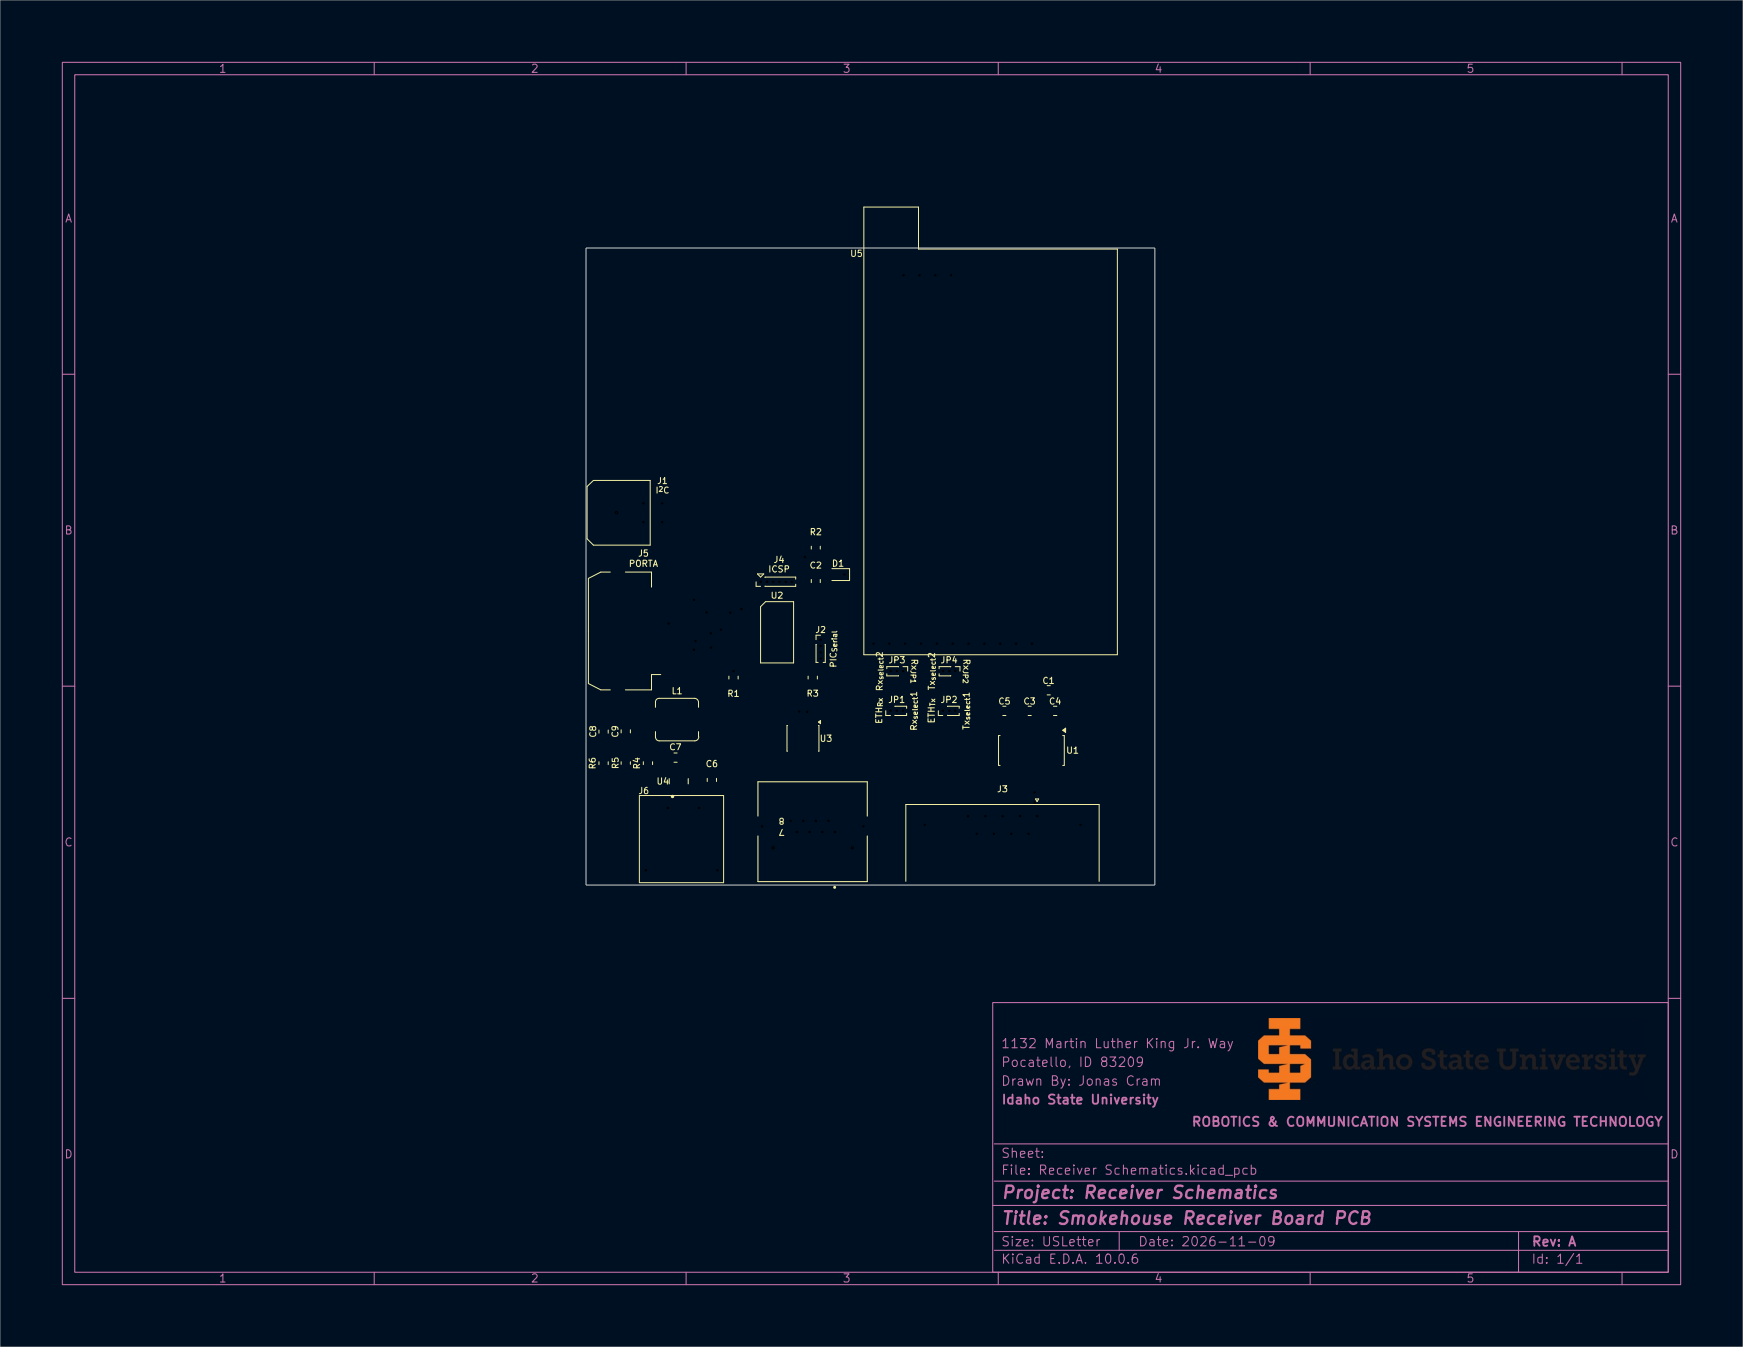
[picture p37: page 7]

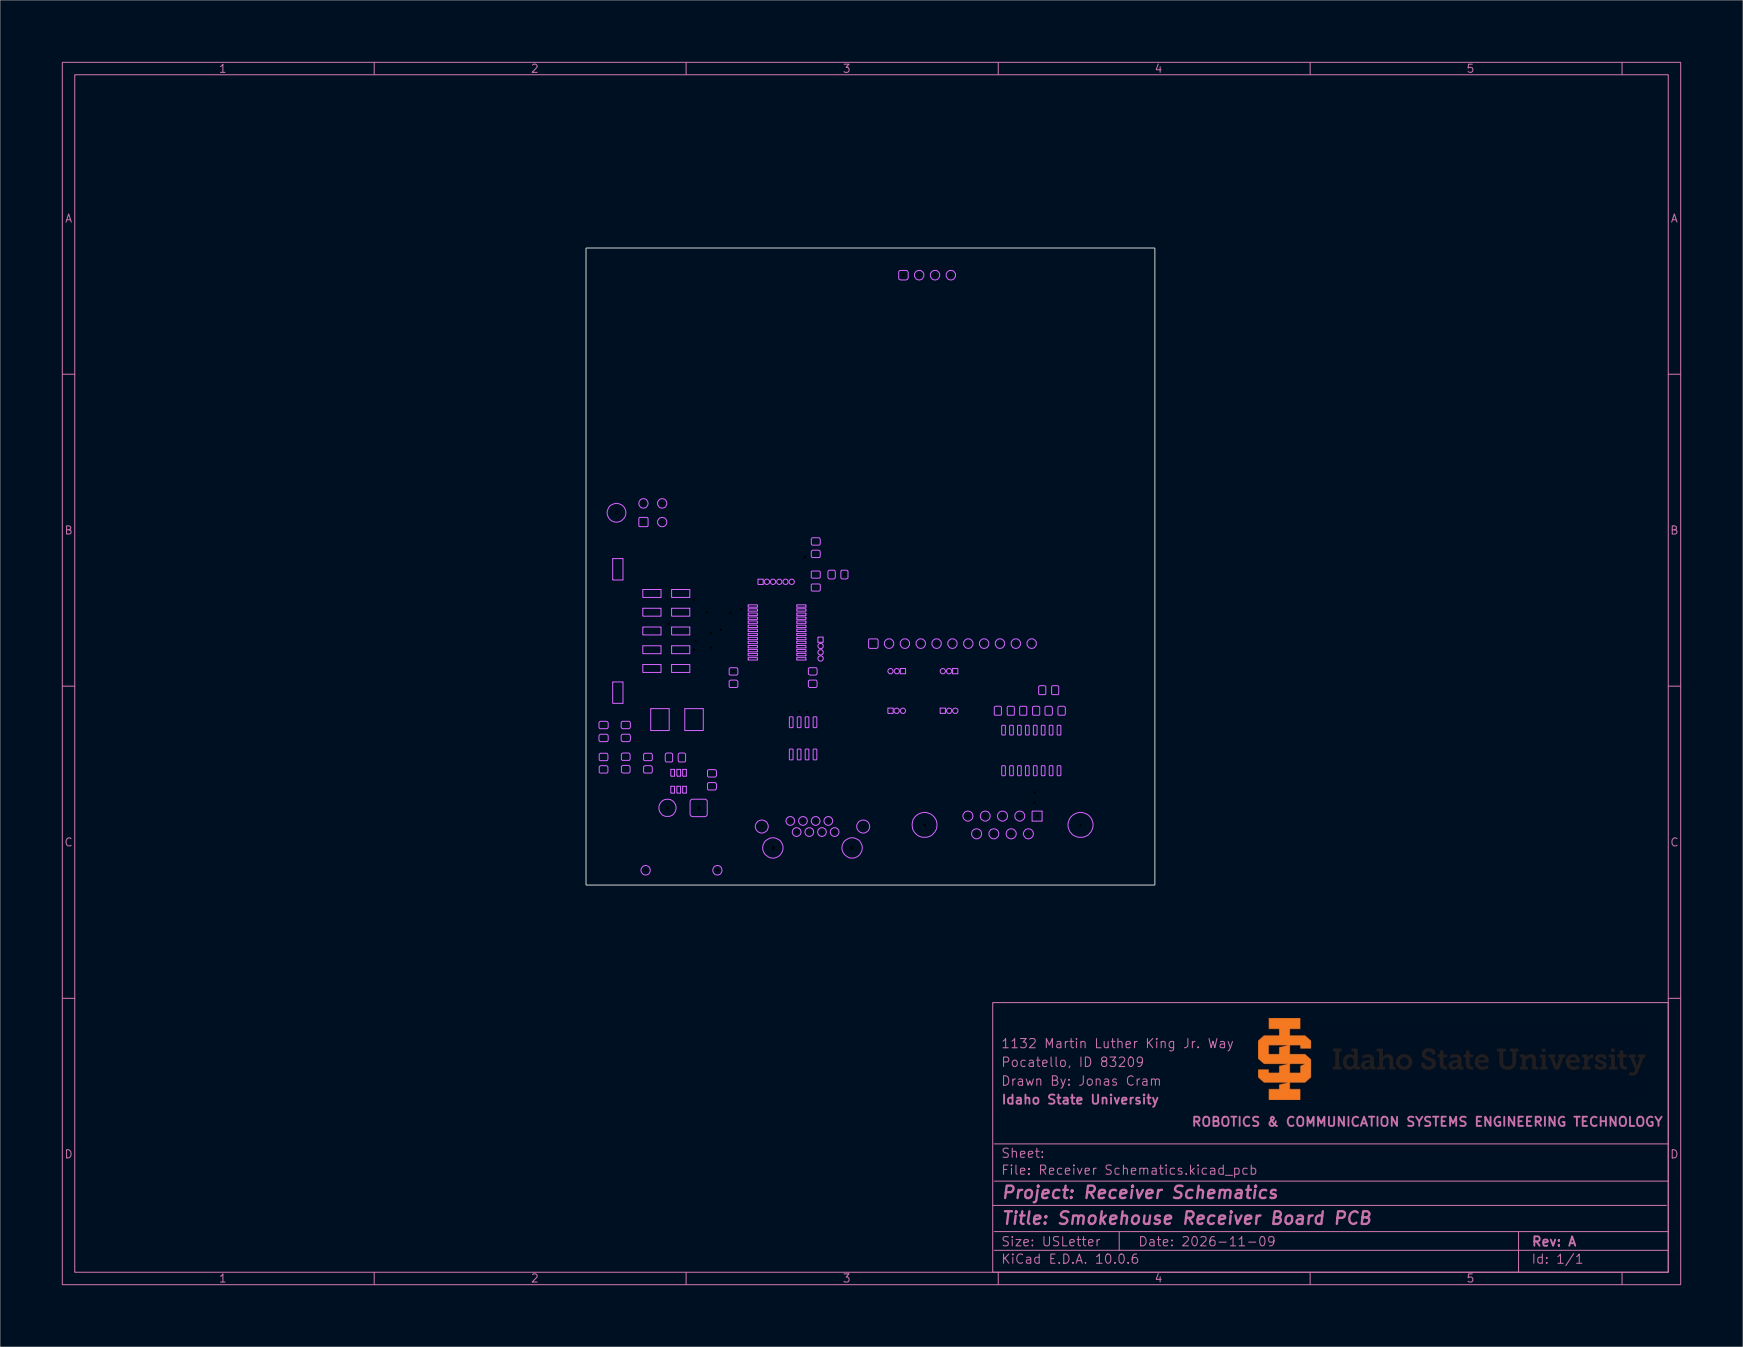
[picture p38: page 9]

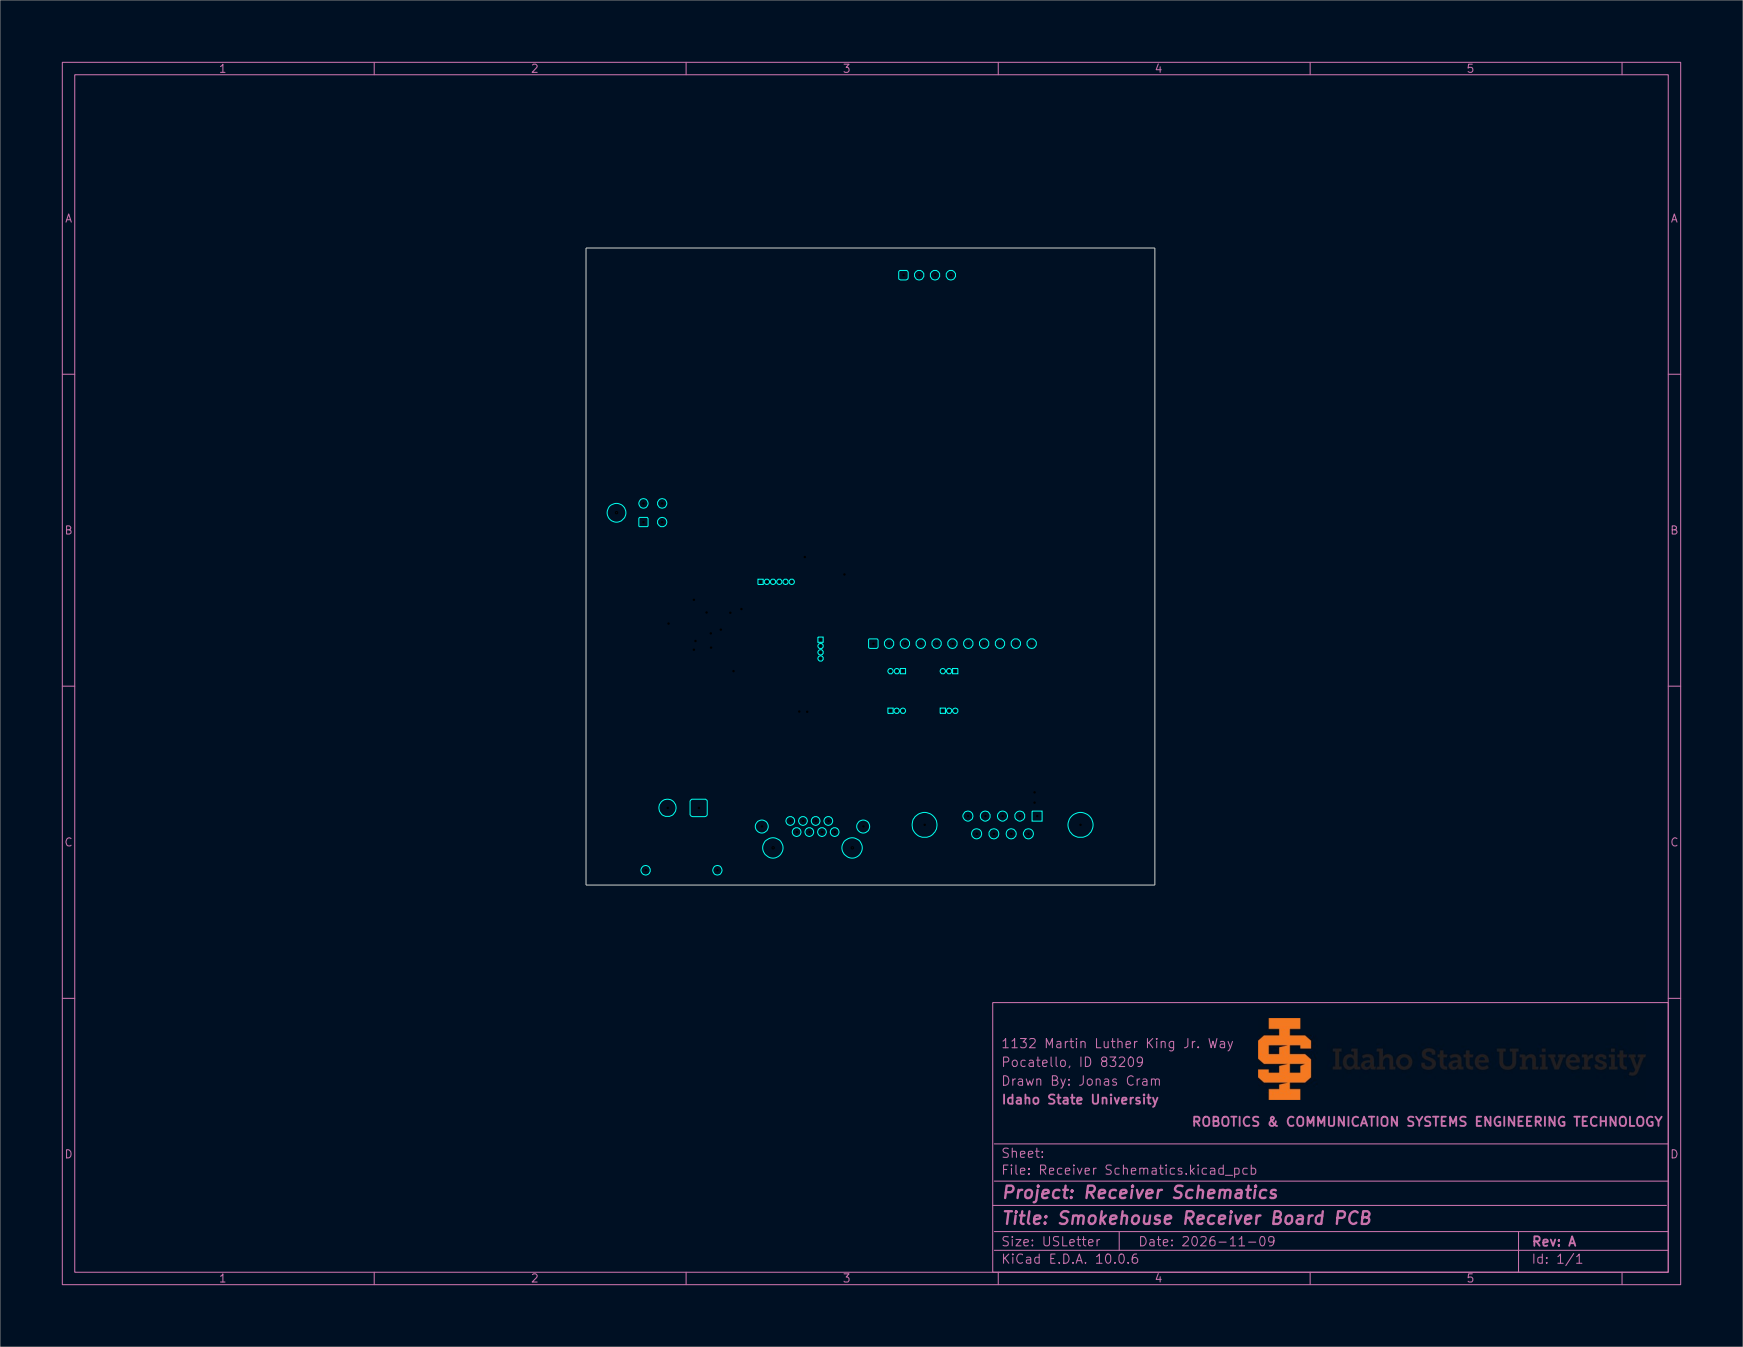
[picture p39: page 10]

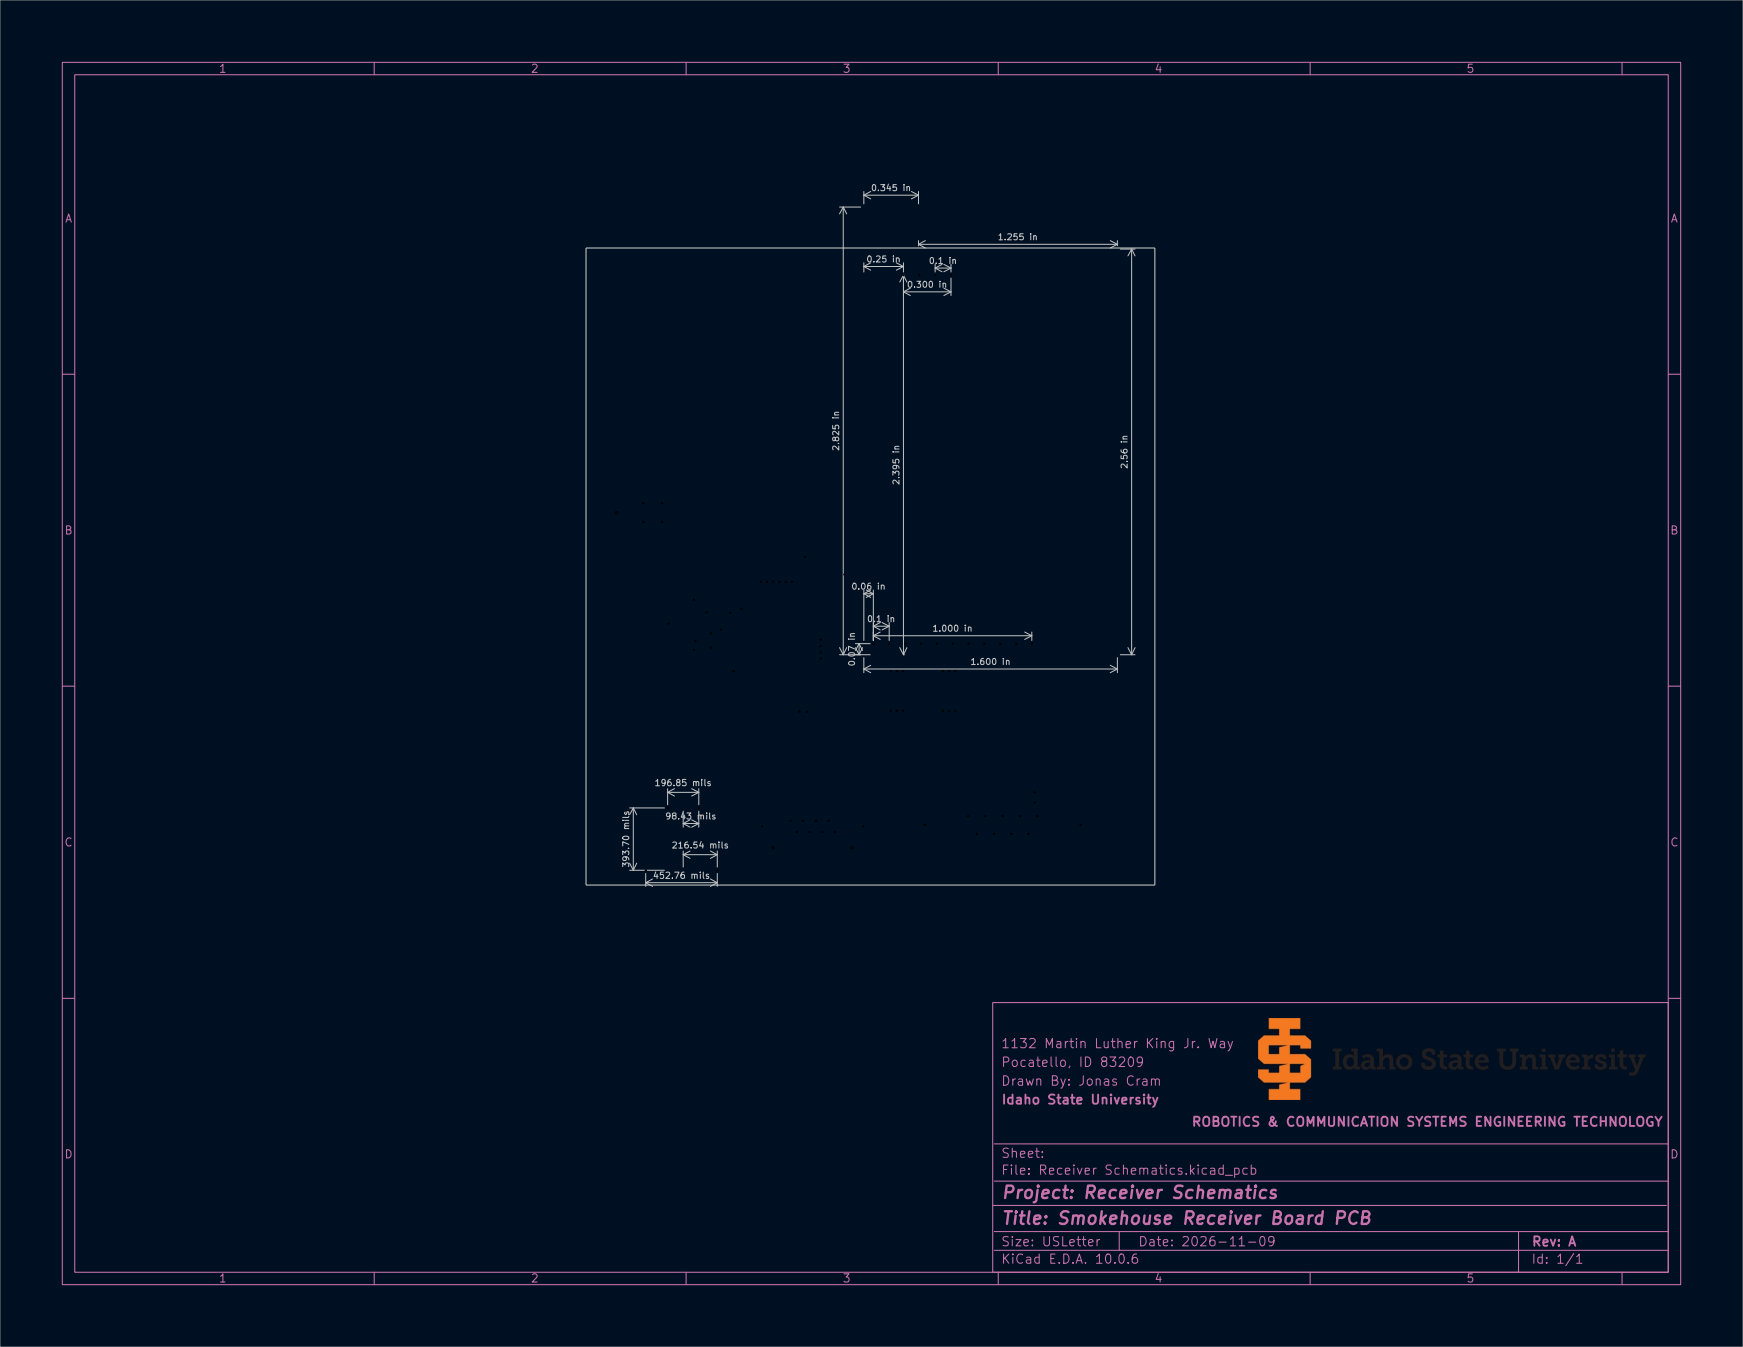
[picture p40: page 11]

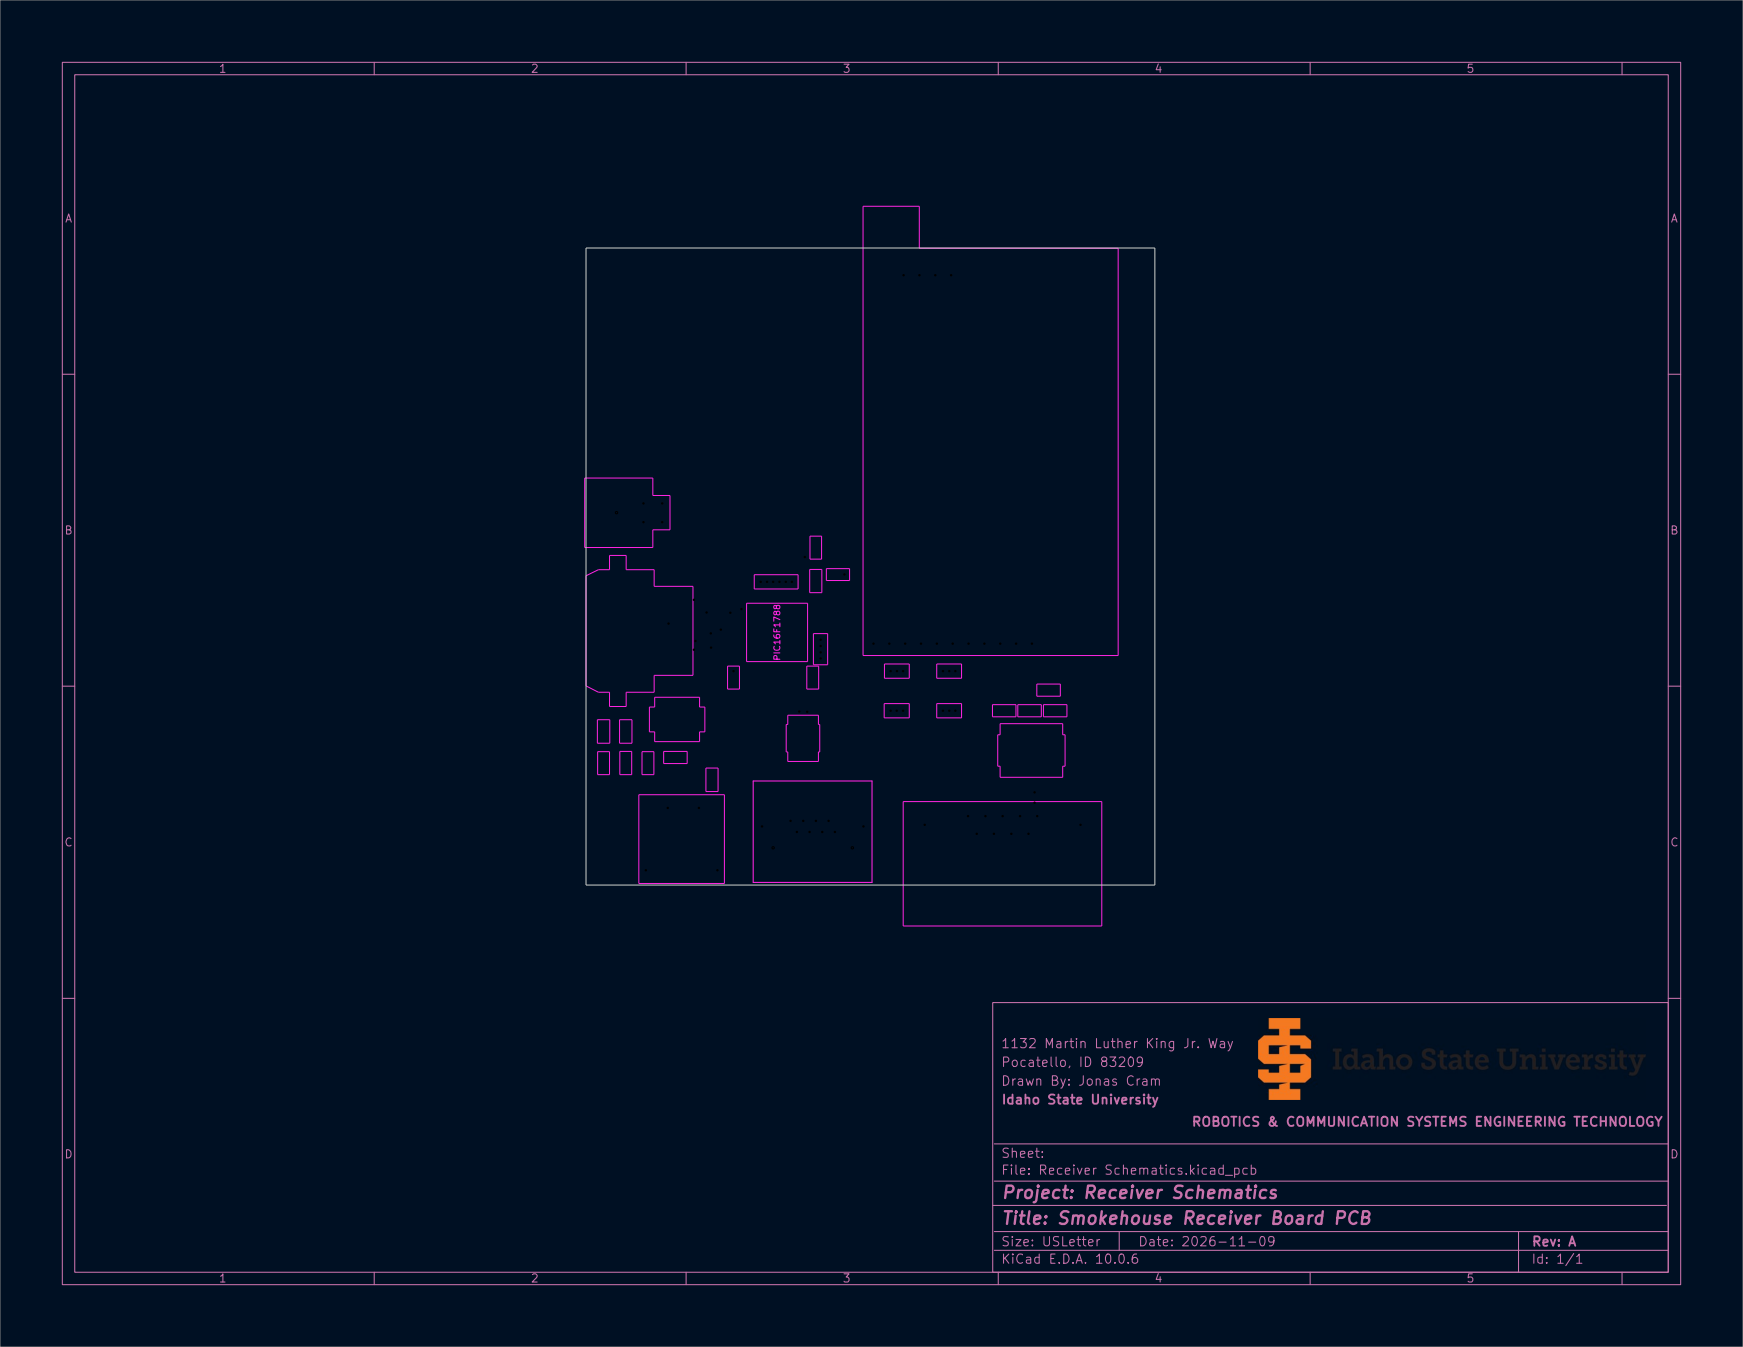
[picture p41: page 14]

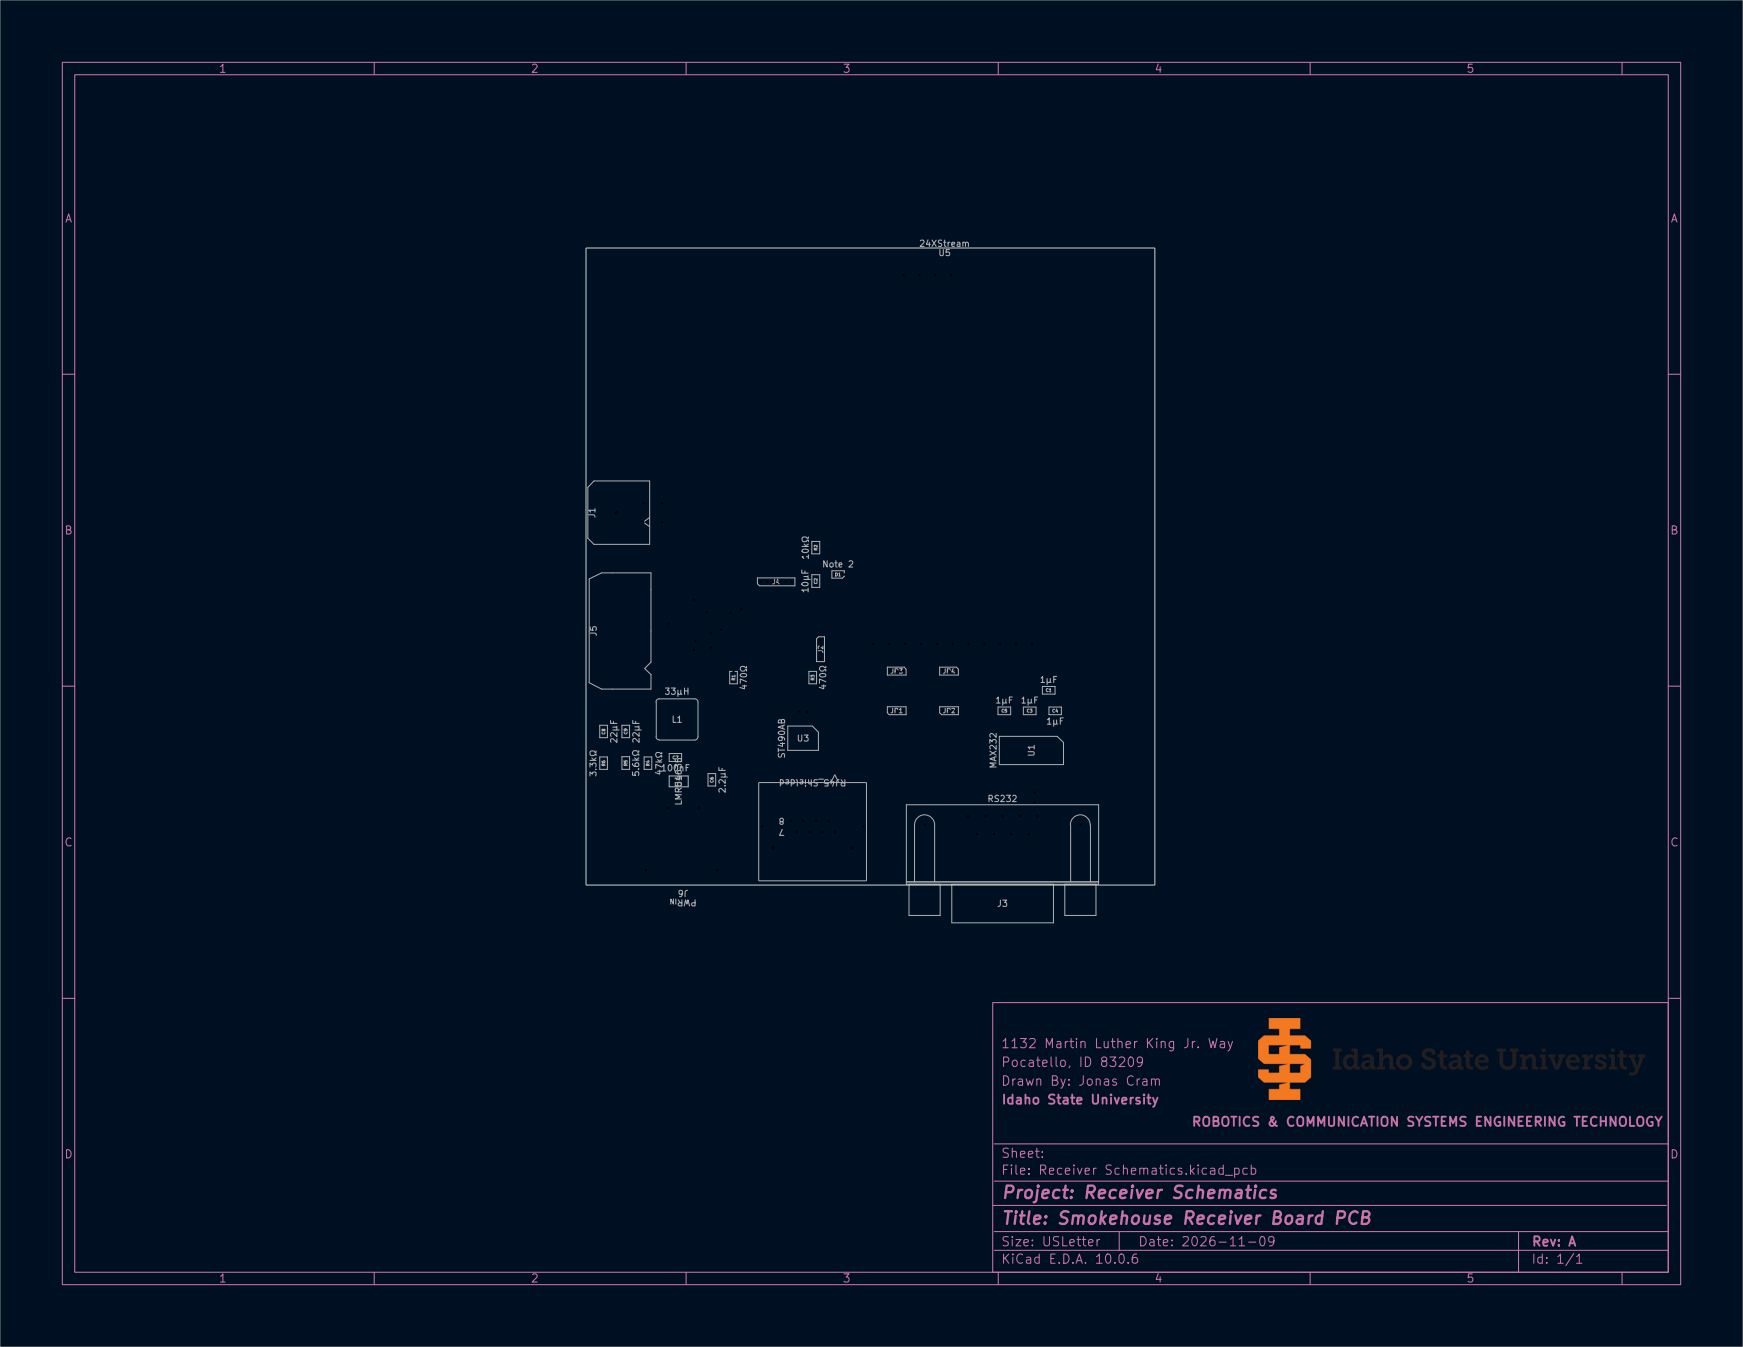
[picture p42: page 16]
