JonCra/Smokehouse/ControlStation/Schematics/Board 1 - Control Station_MASTER/Smokehouse_ControlBoard_Schematic.pdf

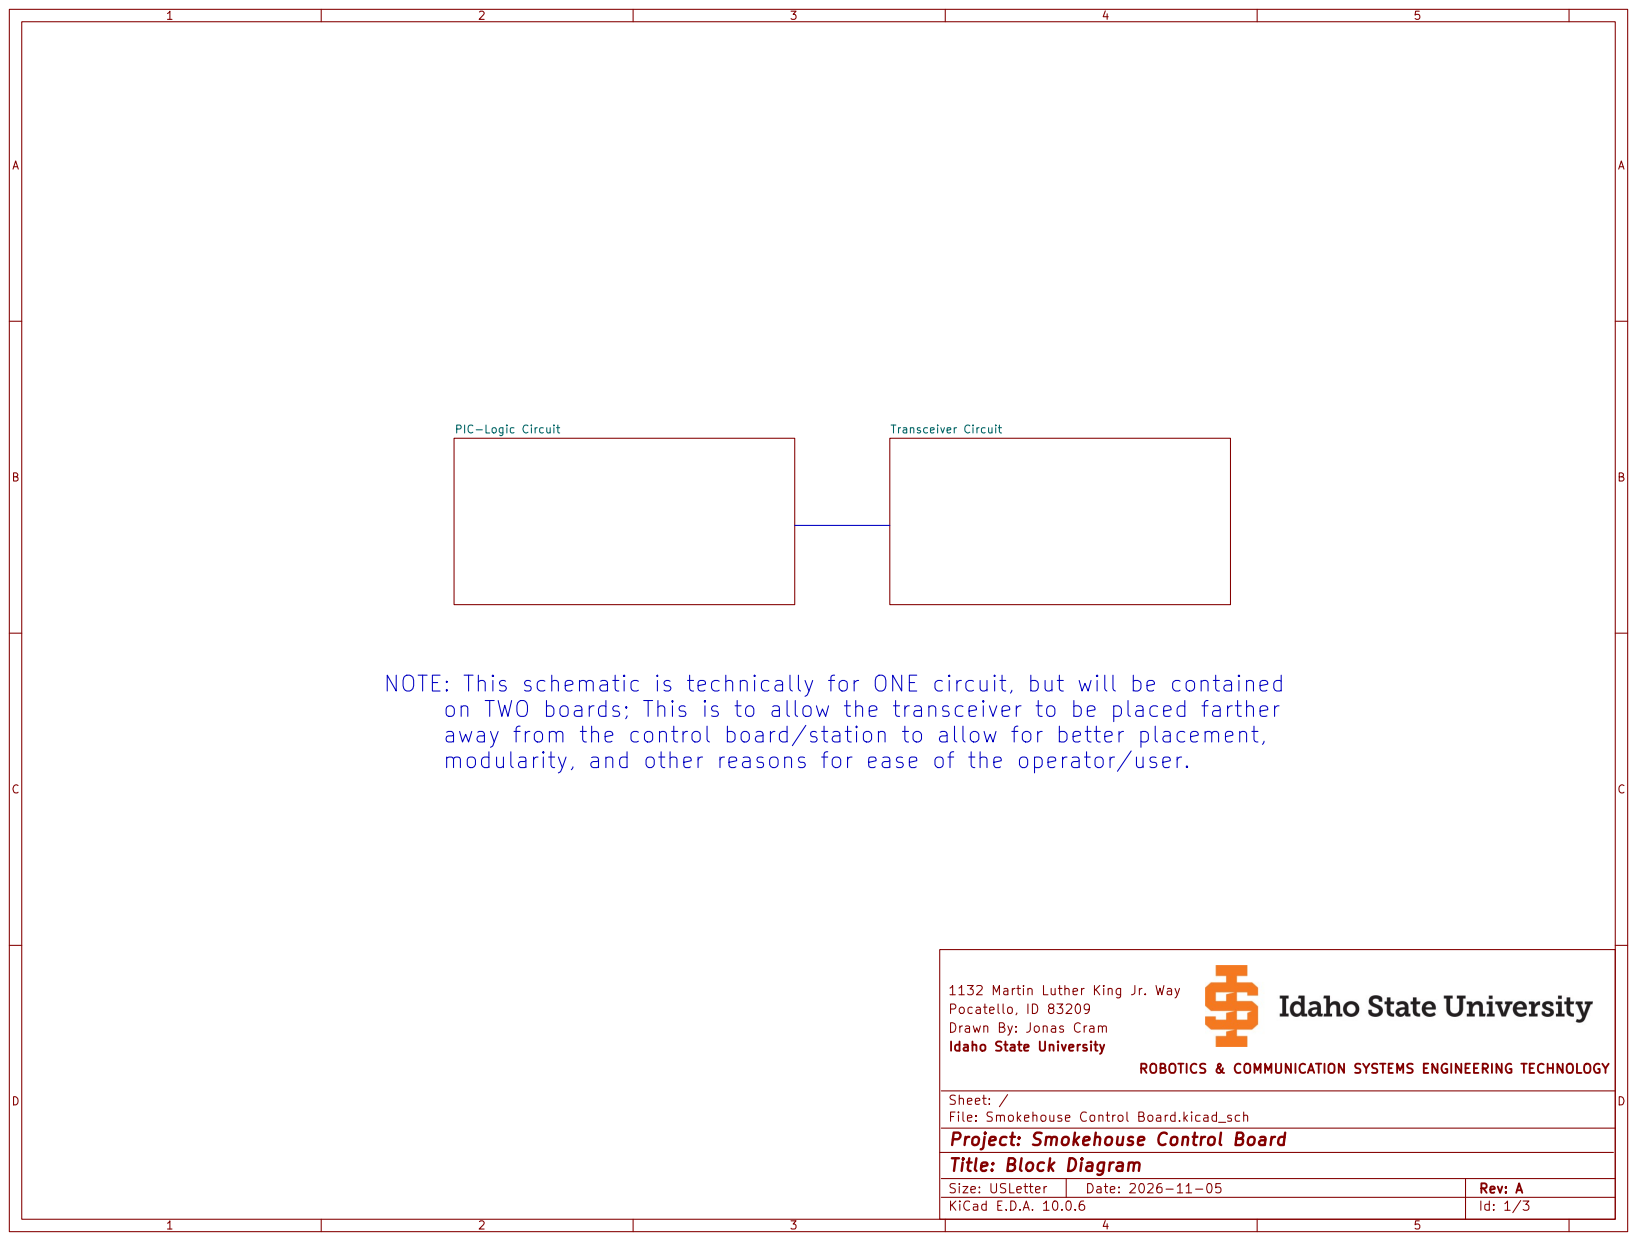
[picture p43: page 1]

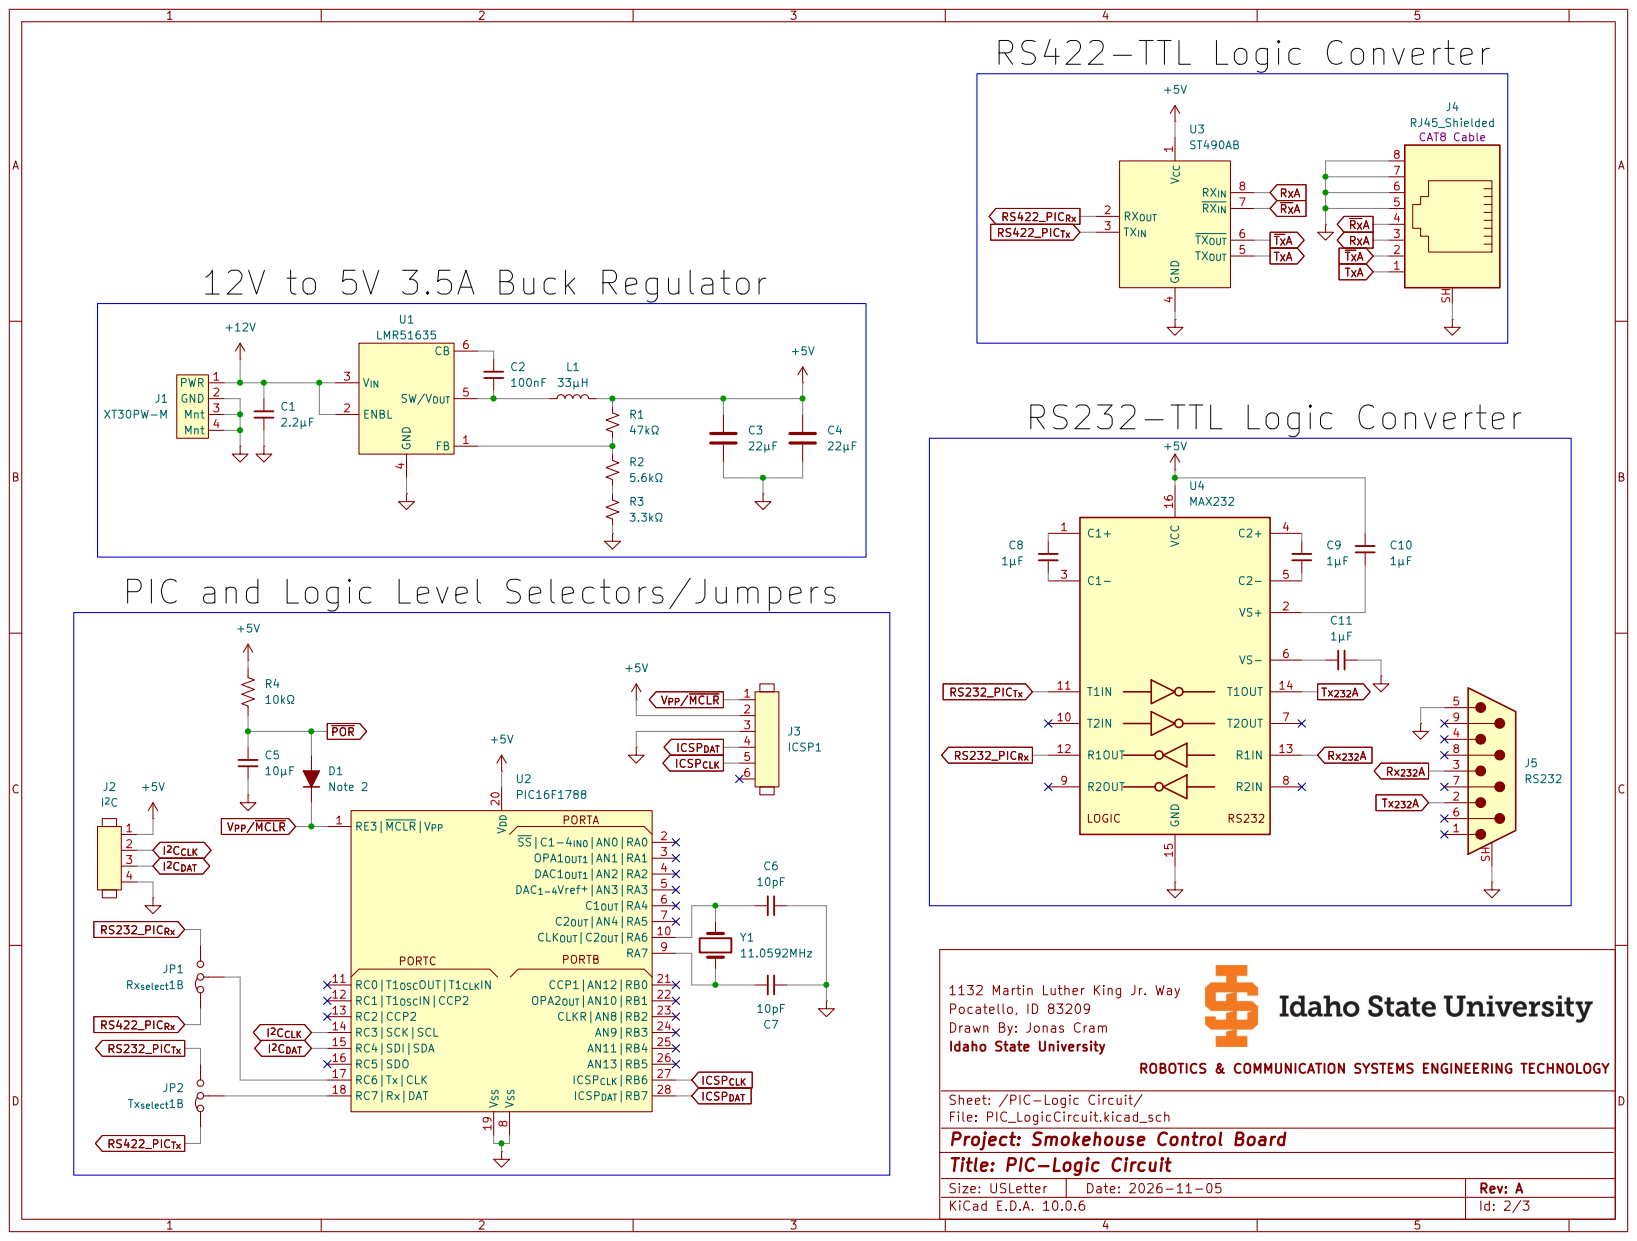
[picture p44: page 2]

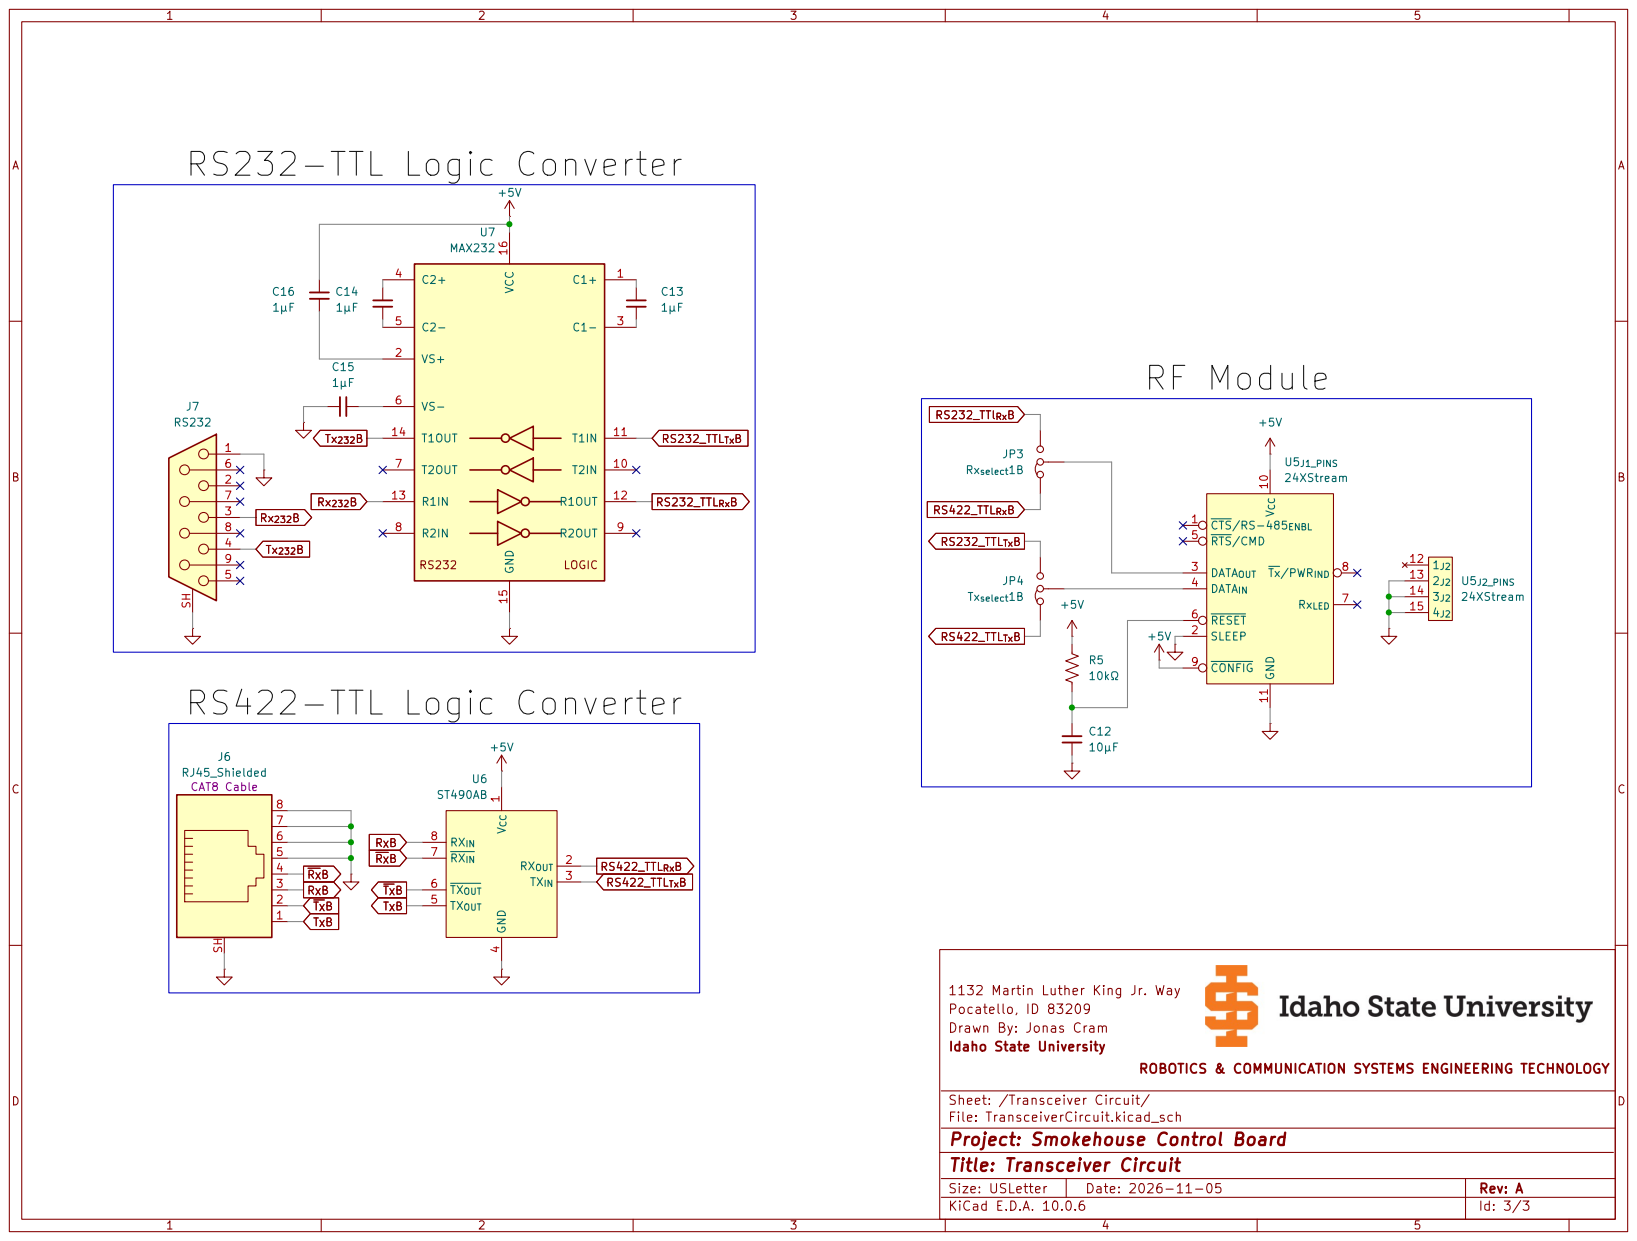
[picture p45: page 3]
