JonCra/Smokehouse/ControlStation/Schematics/Board 1 - Control Station_MASTER/Smokehouse_ControlBoard_SchematicBW.pdf

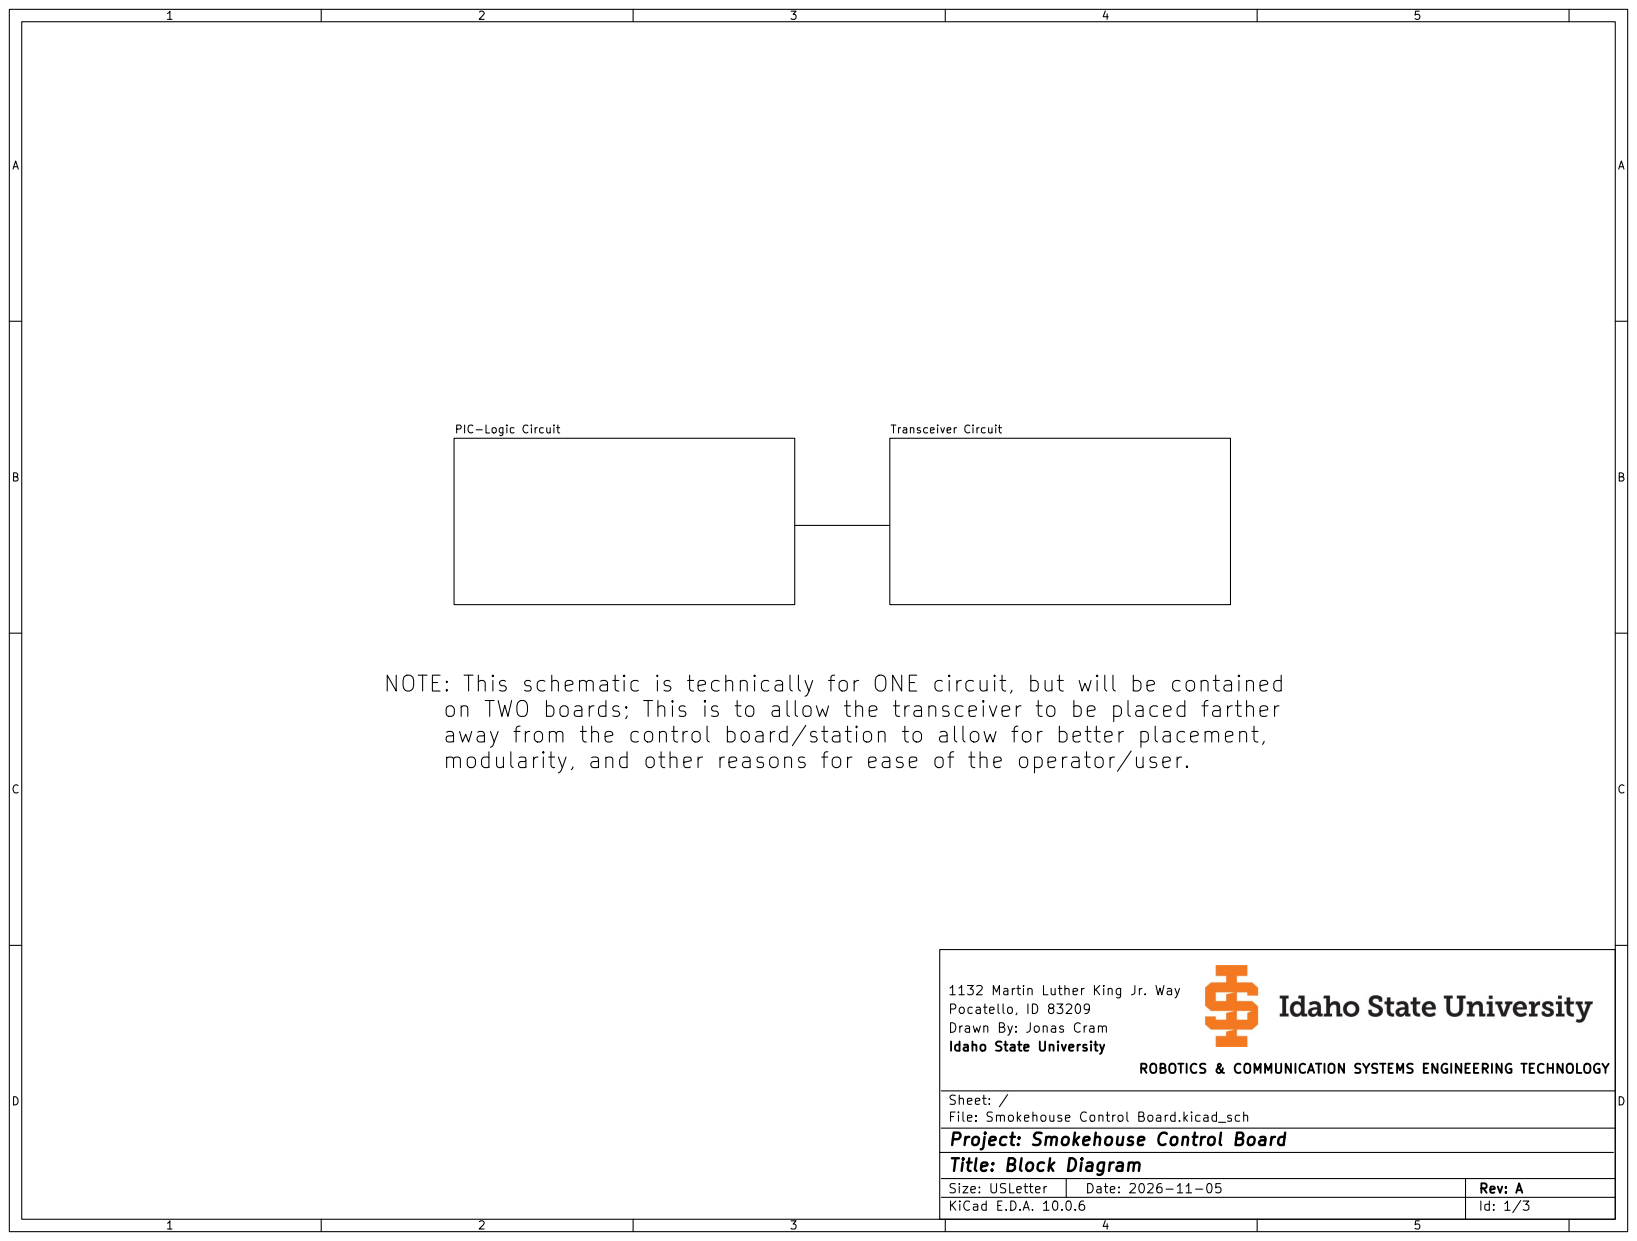
[picture p46: page 1]

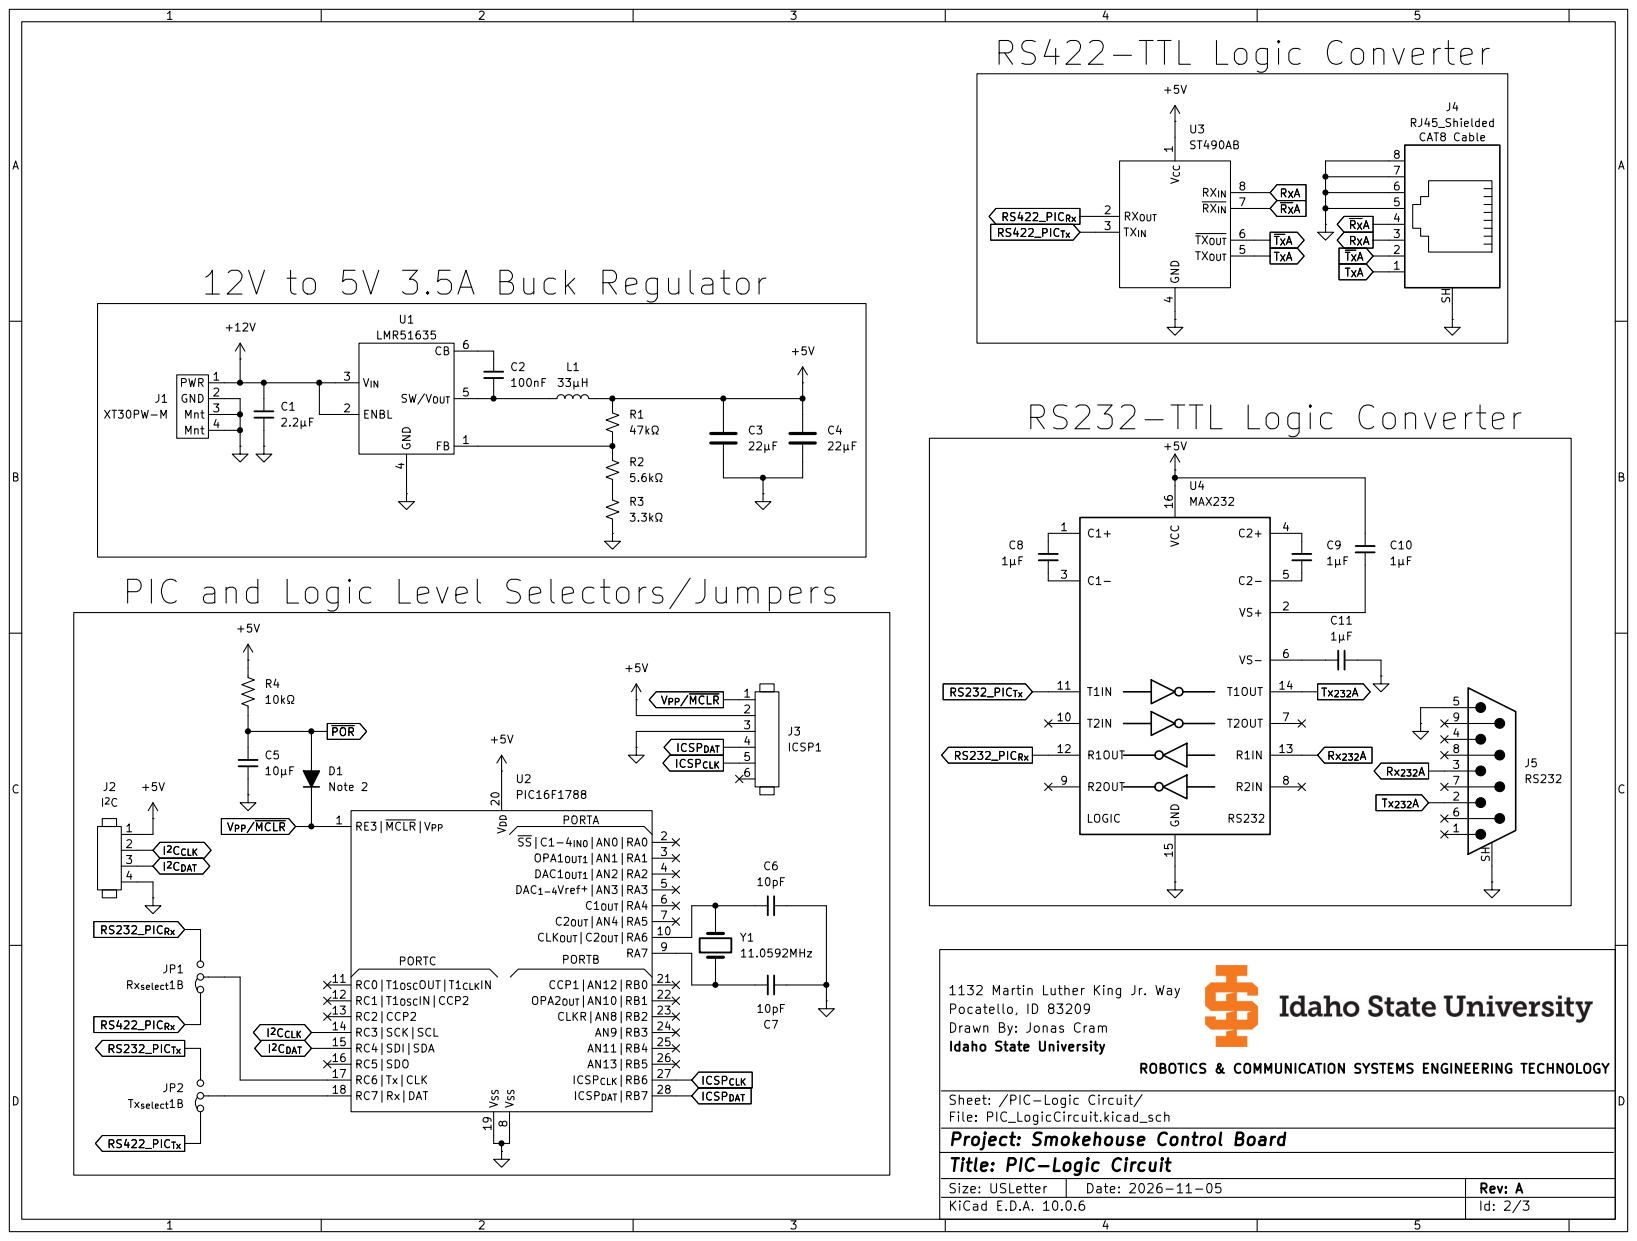
[picture p47: page 2]

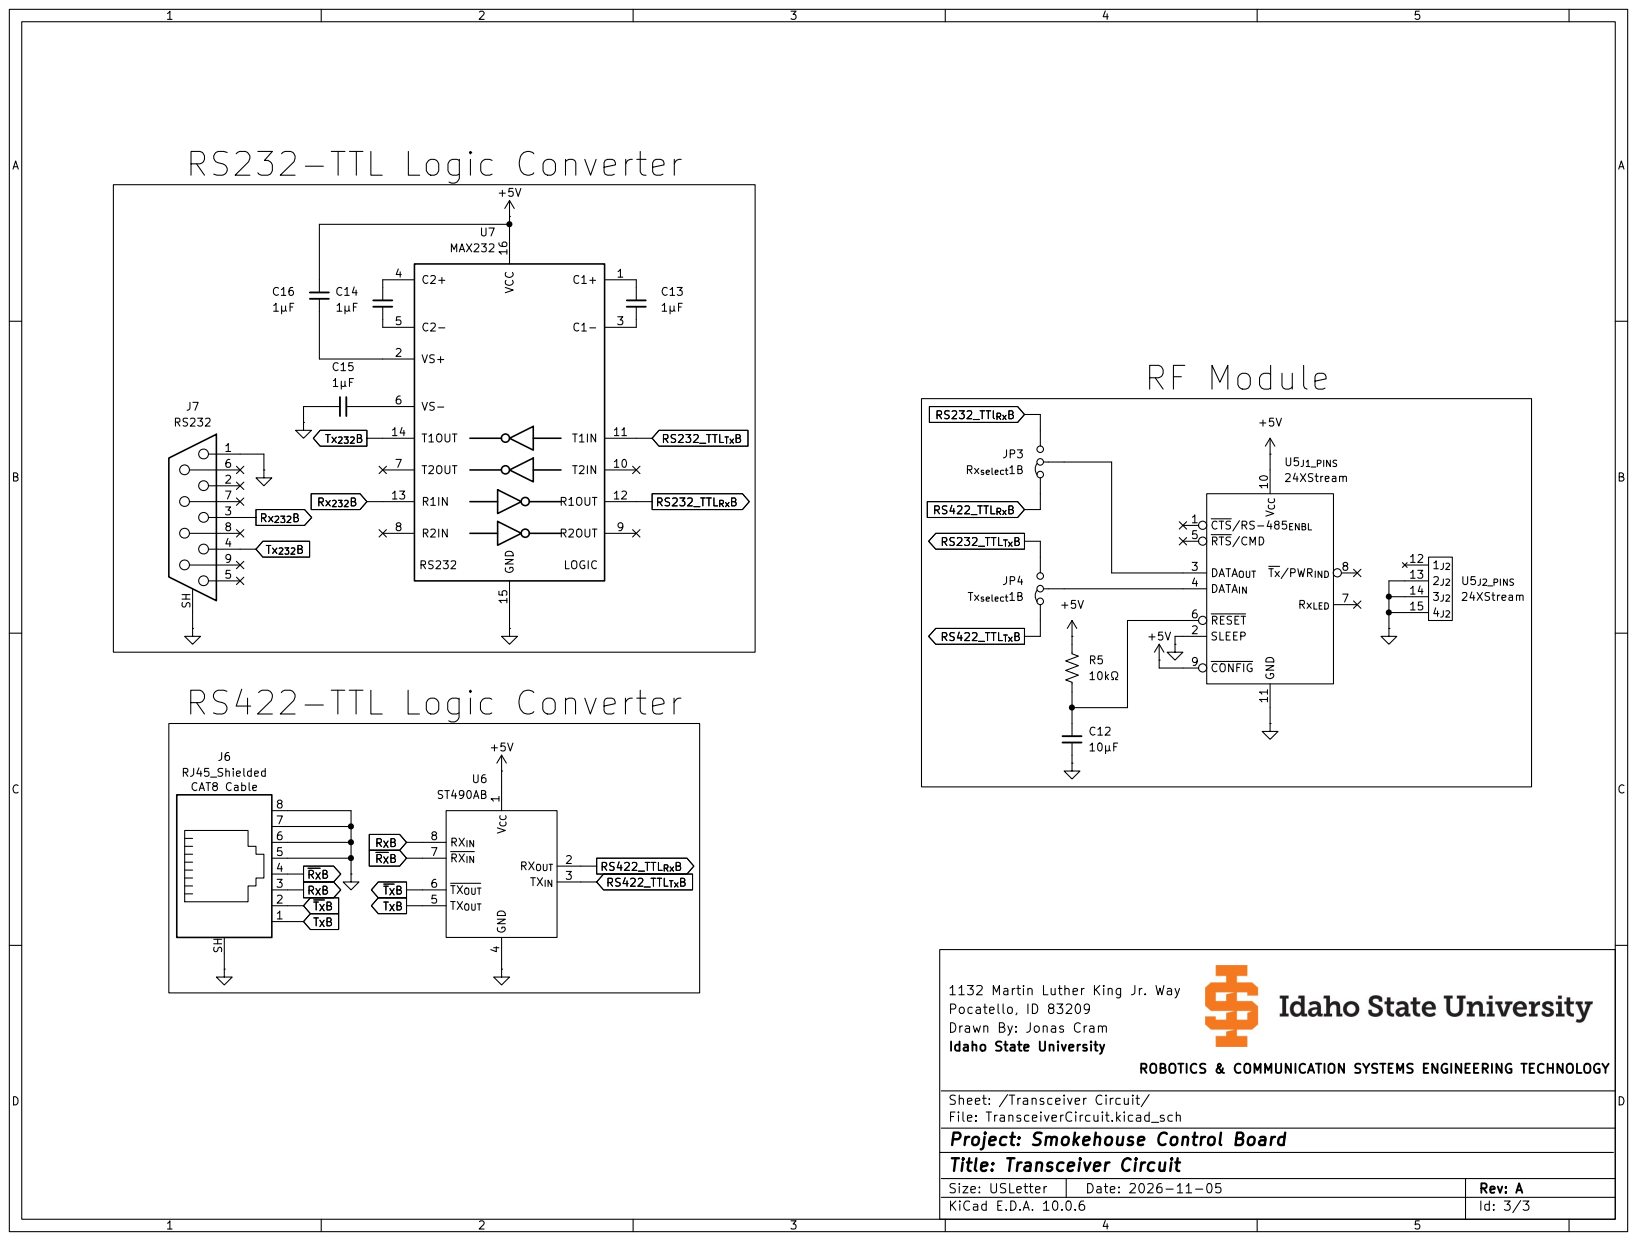
[picture p48: page 3]
