JonCra/Smokehouse/ControlStation/Schematics/Board 1 - Control Station_MASTER/KiCad_Files/Control Station Schematics.kicad_pcb

## KiCad design ControlStation/Schematics/Board 1 - Control Station_MASTER/KiCad_Files/Control Station Schematics.kicad_pcb (2026-11-13)

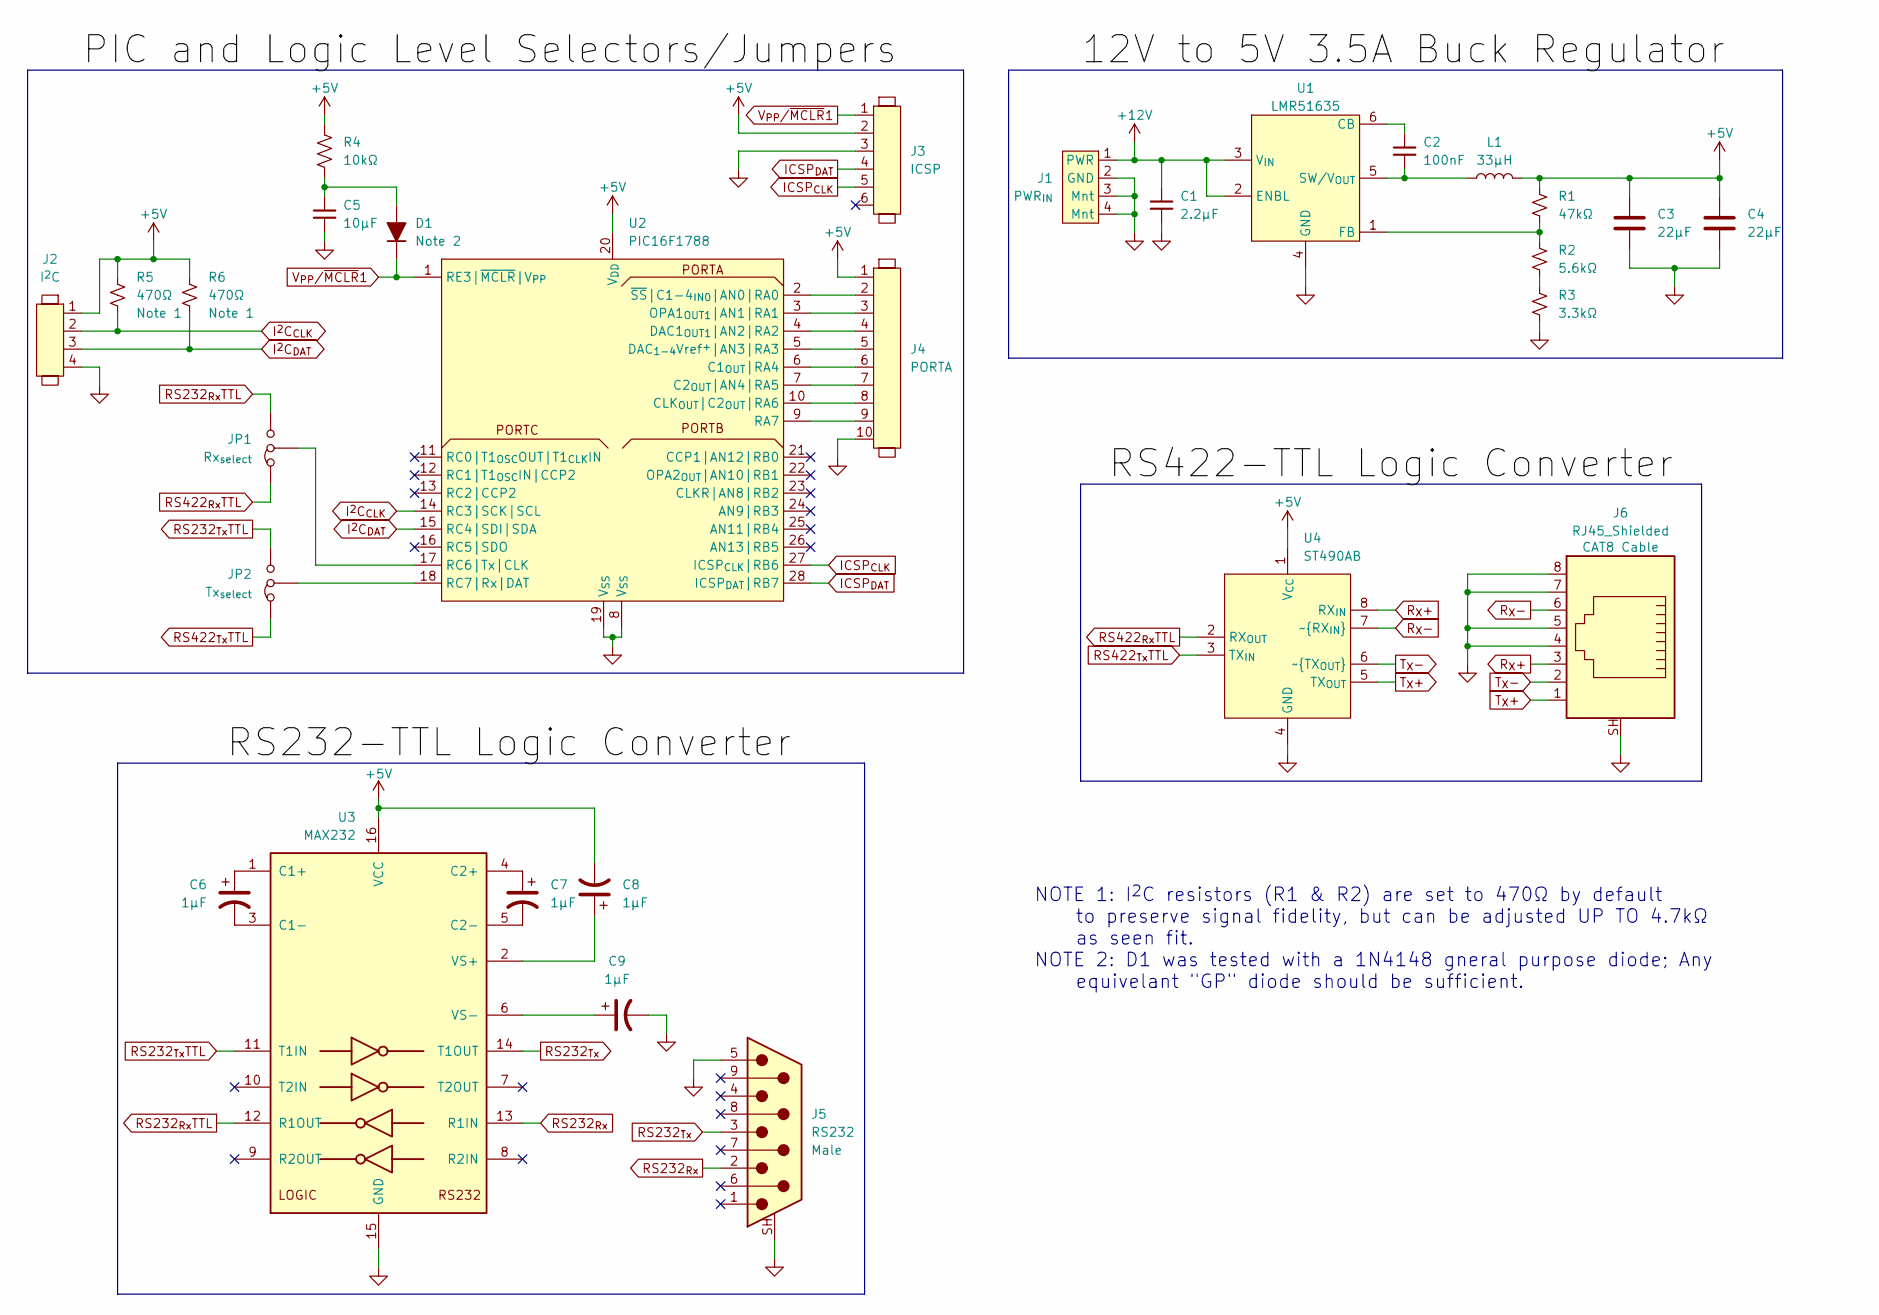
[picture p49: schematic Control Station Schematics.kicad_sch, Block Diagram]

Parts:
C1: 2.2μF; C_0805_2012Metric_Pad1.18x1.45mm_HandSolder
C2: 100nF; C_0805_2012Metric_Pad1.18x1.45mm_HandSolder
C3, C4: 22μF; C_0805_2012Metric_Pad1.18x1.45mm_HandSolder
C5: 10μF; C_0805_2012Metric_Pad1.18x1.45mm_HandSolder
C6, C7, C8, C9: 1μF; C_0805_2012Metric_Pad1.18x1.45mm_HandSolder
D1: D_0805_2012Metric_Pad1.15x1.40mm_HandSolder
J1: PWR_{IN}; XT30PW-M
J2: I^{2}C; Molex_Micro-Fit_3.0_43045-0400_2x02_P3.00mm_Horizontal
J3: ICSP; PinHeader_1x06_P1.00mm_Vertical
J4: PORTA; Molex_Micro-Fit_3.0_43045-1010_2x05-1MP_P3.00mm_Horizontal
J5: RS232; DSUB-9_Socket_Horizontal_P2.77x2.84mm_EdgePinOffset7.70mm_H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
J6: RJ45_Shielded; CONN8_406541_TEC
JP1: Rx_{select}; PinHeader_1x03_P1.00mm_Vertical
JP2: Tx_{select}; PinHeader_1x03_P1.00mm_Vertical
L1: 33μH; L_Bourns_SRP7028A_7.3x6.6mm
R1: 47kΩ; R_0805_2012Metric_Pad1.20x1.40mm_HandSolder
R2: 5.6kΩ; R_0805_2012Metric_Pad1.20x1.40mm_HandSolder
R3: 3.3kΩ; R_0805_2012Metric_Pad1.20x1.40mm_HandSolder
R4: 10kΩ; R_0805_2012Metric_Pad1.20x1.40mm_HandSolder
R5, R6: 470Ω; R_0805_2012Metric_Pad1.20x1.40mm_HandSolder
U1: LMR51635; DDC0006A-MFG
U2: PIC16F1788; SSOP-28
U3: MAX232; SOP-16_4.55x10.3mm_P1.27mm
U4: ST490AB; SO-8_3.9x4.9mm_P1.27mm

Connections:
+12V: C1.1, J1.1 (PWR), U1.2 (ENBL), U1.3 (V_{IN})
GND: C1.2, C3.2, C4.2, C5.2, C9.2, J1.2 (GND), J1.3 (Mnt), J1.4 (Mnt), J2.4, J3.3, J4.10, J5.5, J5.SH (PAD), J6.4, J6.5, J6.7, J6.8, J6.SH, R3.2, U1.4 (GND), U2.8 (V_{SS}), U2.19 (V_{SS}), U3.15 (GND), U4.4 (GND)
ICSP_{CLK}: J3.5, U2.27 (ICSP_{CLK}|RB6)
ICSP_{DAT}: J3.4, U2.28 (ICSP_{DAT}|RB7)
I^{2}C_{CLK}: J2.2, R5.2, U2.14 (RC3|SCK|SCL)
I^{2}C_{DAT}: J2.3, R6.2, U2.15 (RC4|SDI|SDA)
unnamed: C5.1, D1.2 (A), R4.2
unnamed: JP1.2 (C), U2.17 (RC6|Tx|CLK)
unnamed: JP2.2 (C), U2.18 (RC7|Rx|DAT)
unnamed: R2.2, R3.1
unnamed: C2.1, U1.6 (CB)
unnamed: R1.2, R2.1, U1.1 (FB)
unnamed: C2.2, L1.1, U1.5 (SW/V_{OUT})
unnamed: J4.6, U2.6 (C1_{OUT}|RA4)
unnamed: J4.7, U2.7 (C2_{OUT}|AN4|RA5)
unnamed: J4.8, U2.10 (CLK_{OUT}|C2_{OUT}|RA6)
unnamed: J4.4, U2.4 (DAC1_{OUT1}|AN2|RA2)
unnamed: J4.5, U2.5 (DAC_{1-4}Vref^{+}|AN3|RA3)
unnamed: J4.3, U2.3 (OPA1_{OUT1}|AN1|RA1)
unnamed: J4.9, U2.9 (RA7)
unnamed: J4.2, U2.2 (~SS|C1-4_{IN0}|AN0|RA0)
unnamed: C6.1, U3.1 (C1+)
unnamed: C6.2, U3.3 (C1-)
unnamed: C7.1, U3.4 (C2+)
unnamed: C7.2, U3.5 (C2-)
unnamed: C8.1, U3.2 (VS+)
unnamed: C9.1, U3.6 (VS-)
RS232_{Rx}: J5.2, U3.13 (R1IN)
RS232_{Rx}TTL: JP1.3 (B), U3.12 (R1OUT)
RS232_{Tx}: J5.3, U3.14 (T1OUT)
RS232_{Tx}TTL: JP2.3 (B), U3.11 (T1IN)
RS422_{Rx}TTL: JP1.1 (A), U4.2 (RX_{OUT})
RS422_{Tx}TTL: JP2.1 (A), U4.3 (TX_{IN})
R_{X}+: J6.3, U4.8 (RX_{IN})
R_{X}-: J6.6, U4.7 (~RX_{IN})
T_{X}+: J6.1, U4.5 (TX_{OUT})
T_{X}-: J6.2, U4.6 (~TX_{OUT})
V_{PP}/~MCLR1: D1.1 (K), J3.1, U2.1 (RE3|~MCLR|V_{PP})

Notes on the sheet:
NOTE 1: I^{2}C resistors (R1 & R2) are set to 470Ω by default to preserve signal fidelity, but can be adjusted UP TO 4.7kΩ as seen fit. NOTE 2: D1 was tested with a 1N4148 gneral purpose diode; Any equivelant "GP" diode should be sufficient.

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
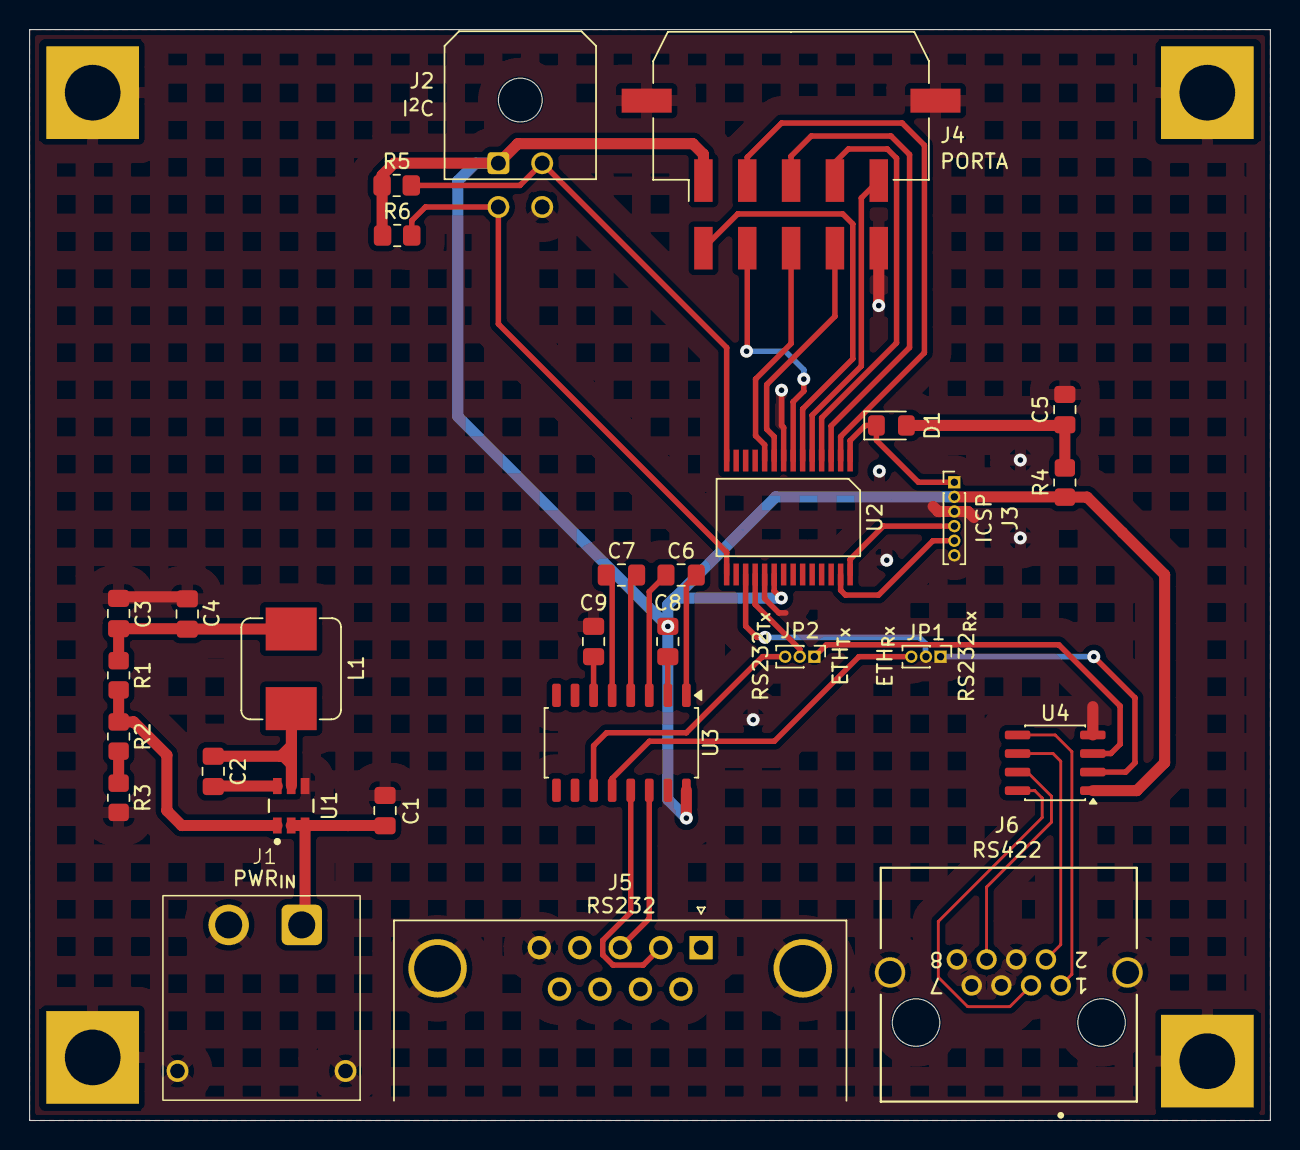
[picture p50: board Control Station Schematics.kicad_pcb from above]

Board: 2 copper layers, 84.9 x 74.7 mm, 29 parts (0 on the bottom side), 40 nets.
