JonCra/Smokehouse/ControlStation/Schematics/Board 2 - Receiver_SLAVE/Receiver Schematics.kicad_pcb

## KiCad design ControlStation/Schematics/Board 2 - Receiver_SLAVE/Receiver Schematics.kicad_pcb (2026-11-10)

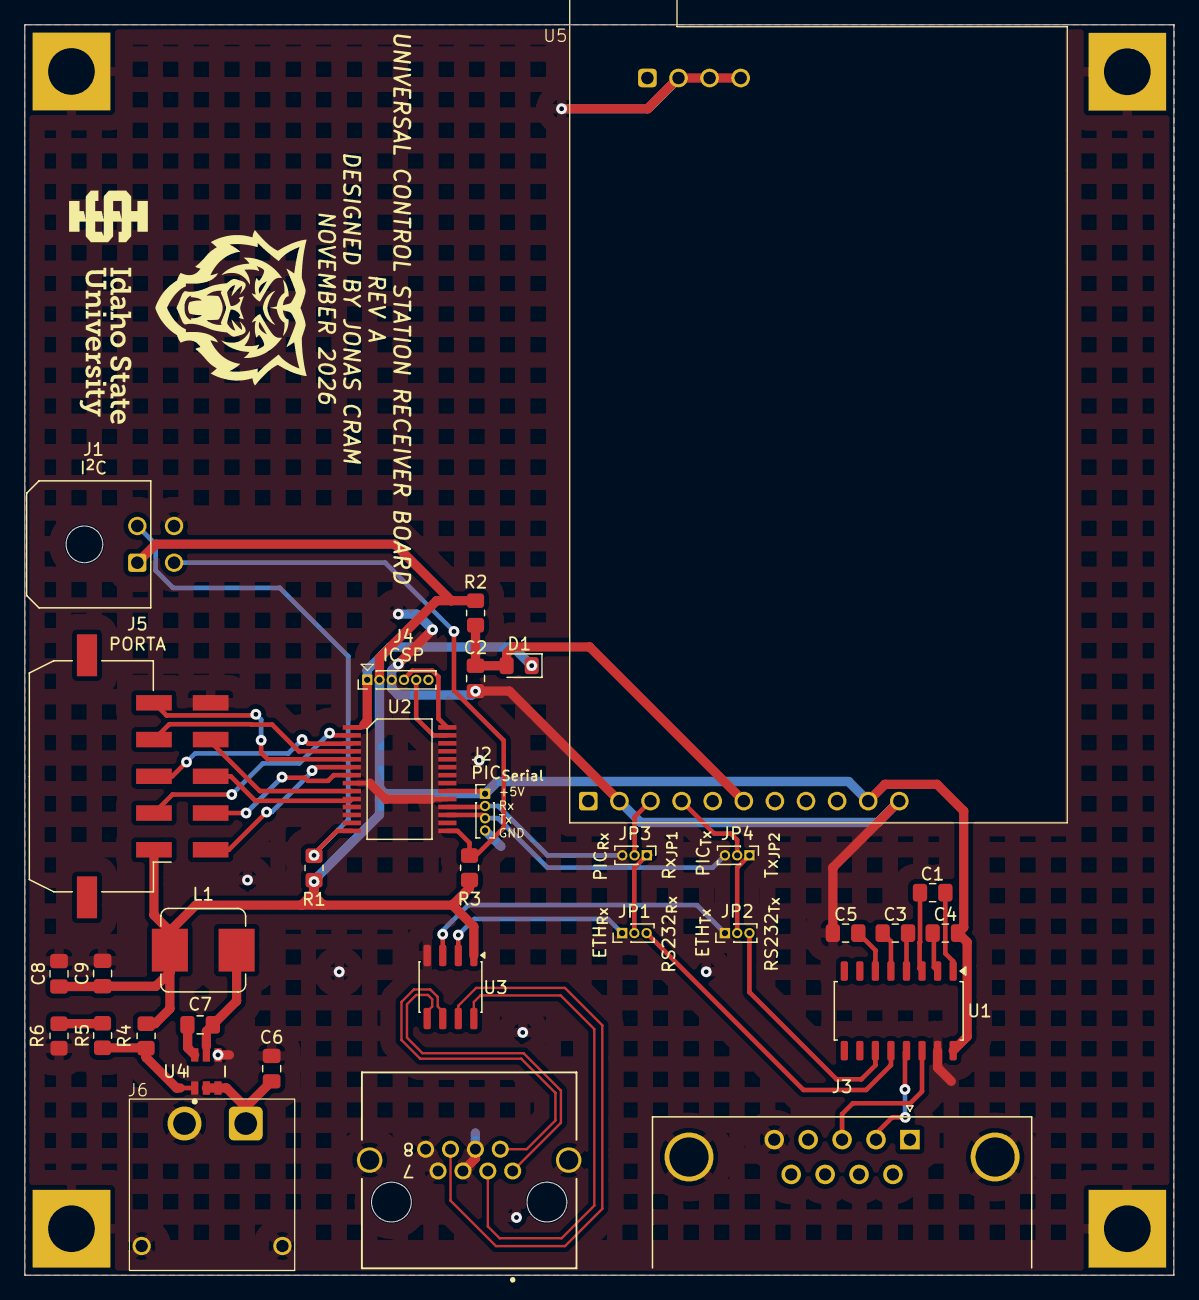
[picture p51: board Receiver Schematics.kicad_pcb from above]

Board: 2 copper layers, 93.9 x 102.1 mm, 33 parts (0 on the bottom side), 43 nets.

Parts:
C1, C3, C4, C5: 1μF; C_0805_2012Metric_Pad1.18x1.45mm_HandSolder
C2: 10μF; C_0805_2012Metric_Pad1.18x1.45mm_HandSolder
C6: 2.2μF; C_0805_2012Metric_Pad1.18x1.45mm_HandSolder
C7: 100nF; C_0805_2012Metric_Pad1.18x1.45mm_HandSolder
C8, C9: 22μF; C_0805_2012Metric_Pad1.18x1.45mm_HandSolder
D1: Note 2; D_0805_2012Metric_Pad1.15x1.40mm_HandSolder
J1: I^{2}C; Molex_Micro-Fit_3.0_43045-0400_2x02_P3.00mm_Horizontal
J2: PIC_{Serial}; PinHeader_1x04_P1.00mm_Vertical
J3: RS232; DSUB-9_Socket_Horizontal_P2.77x2.84mm_EdgePinOffset7.70mm_H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
J4: ICSP; PinHeader_1x06_P1.00mm_Vertical
J5: PORTA; Molex_Micro-Fit_3.0_43045-1010_2x05-1MP_P3.00mm_Horizontal
J6: PWR_{IN}; XT30PW-M
J7: RJ45_Shielded; CONN8_406541_TEC
JP1: Rx_{select}1; PinHeader_1x03_P1.00mm_Vertical
JP2: Tx_{select}1; PinHeader_1x03_P1.00mm_Vertical
JP3: Rx_{select}2; PinHeader_1x03_P1.00mm_Vertical
JP4: Tx_{select}2; PinHeader_1x03_P1.00mm_Vertical
L1: 33μH; L_Bourns_SRP7028A_7.3x6.6mm
R1, R3: 470Ω; R_0805_2012Metric_Pad1.20x1.40mm_HandSolder
R2: 10kΩ; R_0805_2012Metric_Pad1.20x1.40mm_HandSolder
R4: 47kΩ; R_0805_2012Metric_Pad1.20x1.40mm_HandSolder
R5: 5.6kΩ; R_0805_2012Metric_Pad1.20x1.40mm_HandSolder
R6: 3.3kΩ; R_0805_2012Metric_Pad1.20x1.40mm_HandSolder
U1: MAX232; SOP-16_4.55x10.3mm_P1.27mm
U2: PIC16F1788; SSOP-28
U3: ST490AB; SO-8_3.9x4.9mm_P1.27mm
U4: LMR51635; DDC0006A-MFG
U5: 24XStream

Connections:
+5V: C4.2, C8.1, C9.1, J1.1, J2.1, J4.2, J5.1, L1.2, R1.1, R2.1, R3.1, R4.1, U1.16 (VCC), U2.20 (V_{DD}), U3.1 (V_{CC}), U5.10 (V_{CC})
+12V: C6.1, J6.1 (PWR), U4.2 (ENBL), U4.3 (V_{IN})
GND: C2.2, C5.2, C6.2, C8.2, C9.2, J1.4, J2.4, J3.5, J3.SH (PAD), J4.3, J5.10, J6.2 (GND), J6.3 (Mnt), J6.4 (Mnt), J7.4, J7.5, J7.7, J7.8, J7.SH, R6.2, U1.15 (GND), U2.8 (V_{SS}), U2.19 (V_{SS}), U3.4 (GND), U4.4 (GND), U5.2 (SLEEP), U5.11 (GND), U5.13 (2_{J2}), U5.14 (3_{J2}), U5.15 (4_{J2})
ICSP_{CLK}: J4.5, U2.27 (ICSP_{CLK}|RB6)
ICSP_{DAT}: J4.4, U2.28 (ICSP_{DAT}|RB7)
I^{2}C_{CLK}: J1.2, R1.2, U2.14 (RC3|SCK|SCL)
I^{2}C_{DAT}: J1.3, R3.2, U2.15 (RC4|SDI|SDA)
unnamed: JP1.2 (C), JP3.1 (A)
unnamed: JP2.2 (C), JP4.1 (A)
unnamed: JP3.2 (C), U5.3 (DATA_{OUT})
unnamed: JP4.2 (C), U5.4 (DATA_{IN})
unnamed: R5.2, R6.1
unnamed: C1.1, U1.1 (C1+)
unnamed: C1.2, U1.3 (C1-)
unnamed: C3.1, U1.4 (C2+)
unnamed: C3.2, U1.5 (C2-)
unnamed: C4.1, U1.2 (VS+)
unnamed: C5.1, U1.6 (VS-)
unnamed: J5.6, U2.6 (C1_{OUT}|RA4)
unnamed: J5.7, U2.7 (C2_{OUT}|AN4|RA5)
unnamed: J5.8, U2.10 (CLK_{OUT}|C2_{OUT}|RA6)
unnamed: J5.4, U2.4 (DAC1_{OUT1}|AN2|RA2)
unnamed: J5.5, U2.5 (DAC_{1-4}Vref^{+}|AN3|RA3)
unnamed: J5.3, U2.3 (OPA1_{OUT1}|AN1|RA1)
unnamed: J5.9, U2.9 (RA7)
unnamed: J5.2, U2.2 (~SS|C1-4_{IN0}|AN0|RA0)
unnamed: C7.1, U4.6 (CB)
unnamed: R4.2, R5.1, U4.1 (FB)
unnamed: C7.2, L1.1, U4.5 (SW/V_{OUT})
PIC_{Rx}: J2.2, JP3.3 (B), U2.18 (RC7|Rx|DAT)
PIC_{Tx}: J2.3, JP4.3 (B), U2.17 (RC6|Tx|CLK)
RS232_Rx_{TTL}: JP1.3 (B), U1.12 (R1OUT)
RS232_Tx_{TTL}: JP2.3 (B), U1.11 (T1IN)
RS232_{Rx}: J3.2, U1.13 (R1IN)
RS232_{Tx}: J3.3, U1.14 (T1OUT)
RS422_Rx_{TTL}: JP1.1 (A), U3.2 (RX_{OUT})
RS422_Tx_{TTL}: JP2.1 (A), U3.3 (TX_{IN})
R_{X}+: J7.3, U3.8 (RX_{IN})
R_{X}-: J7.6, U3.7 (~RX_{IN})
T_{X}+: J7.1, U3.5 (TX_{OUT})
T_{X}-: J7.2, U3.6 (~TX_{OUT})
V_{PP}/~MCLR: D1.1 (K), J4.1, U2.1 (RE3|~MCLR|V_{PP})
~POR: C2.1, D1.2 (A), R2.2, U5.6 (~RESET)
