JonCra/Smokehouse/(commit log)

2026-10-27 Added typed citation/credit for previous/current contributors
2026-10-27 Added basic structure for control station assembly code
2026-10-27 Adding setup for UART with documentation for potential future changes
2026-10-27 Finish basic setup for UART; Need to I/O ports and other preliminary setup configs before testing
2026-10-27 Added interrupt setup/initial interrupt flag clearing for relevant features with documentation for future potential changes
2026-10-28 Added specified test code for UART Tx/Rx
2026-10-28 Added 5th semester UART test code for PIC16F883; Will verify and translate for the PIC16F1788 as needed.
2026-10-29 Nearly ready to flash UART test code and verify USART operation between 2 PICs and RF mods
2026-10-30 Added untested feature to hopefully make program "universal" for testing UART between 2 PICs.
2026-10-30 Changed a couple of comment descriptions to match the "formatting" of the rest of program
2026-11-02 Test circuit/code works; Need to analyze behavior for documentation purposes.
2026-11-02 Add untracked files and add image assets for both PIC LED indicator periods
2026-11-02 Add image of working test circuit on breadboard to assets
2026-11-02 Add basic structure for interrupts and basic subroutines; Need to flush it out better for specific use, but it's a start.
2026-11-05 Add datahsheets and UART test circuit schematics to applicable folders
2026-11-05 Add folders for schematics of board(s)
2026-11-10 Add KiCad files, images, and assets for Receiver/Slave board
2026-11-10 Update PCB schematics, remove redundant file
2026-11-11 Update receiver board KiCad files and schematics
2026-11-11 Added folder for KiCad files- better organization
2026-11-11 Update schematic files with corrected text errors
2026-11-12 Update Receiver Board KiCad files and add completed BOM excel and PDF files
2026-11-13 Add semi-finalized control Board schematic/PCB files and supporting files
